sigizmund993/ETZ2067/Screenshot_20261101-164036.png

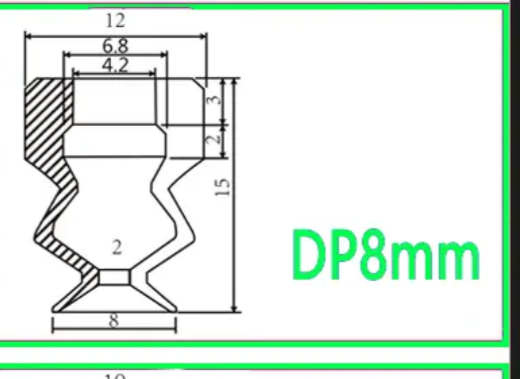
Screenshot_20261101-164036.png
