sigizmund993/ETZ2067/elektronika/etz_plata_3d.png

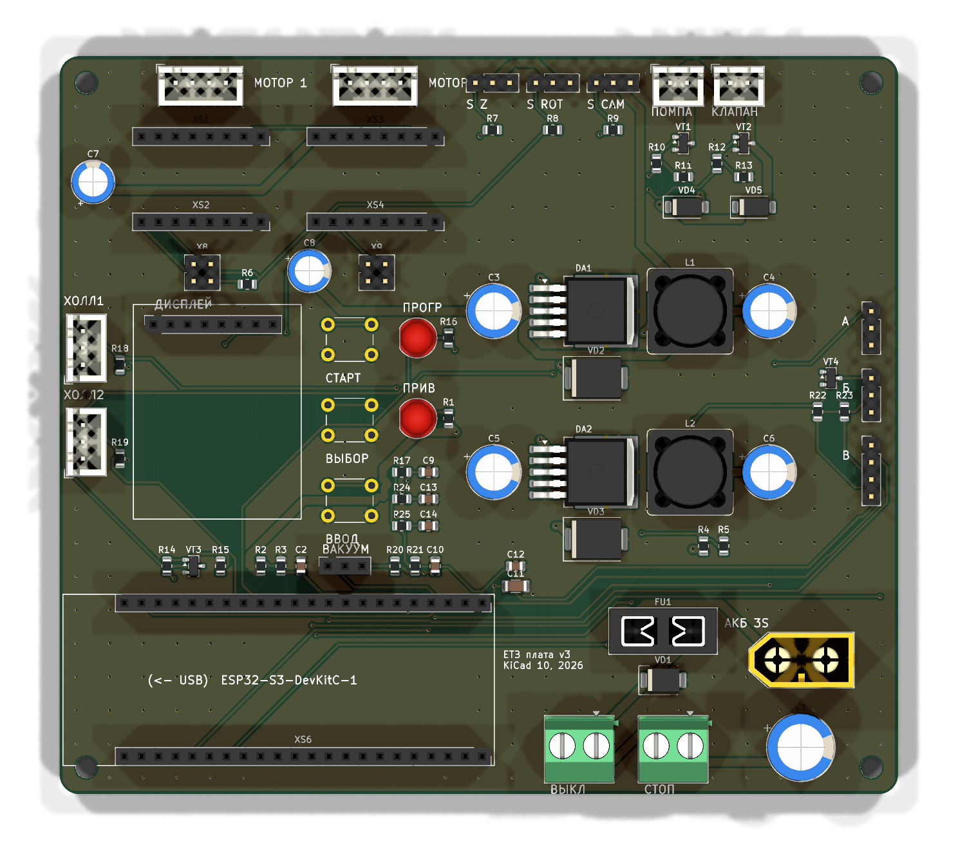
elektronika/etz_plata_3d.png
