sigizmund993/ETZ2067/cam_work_iso.png

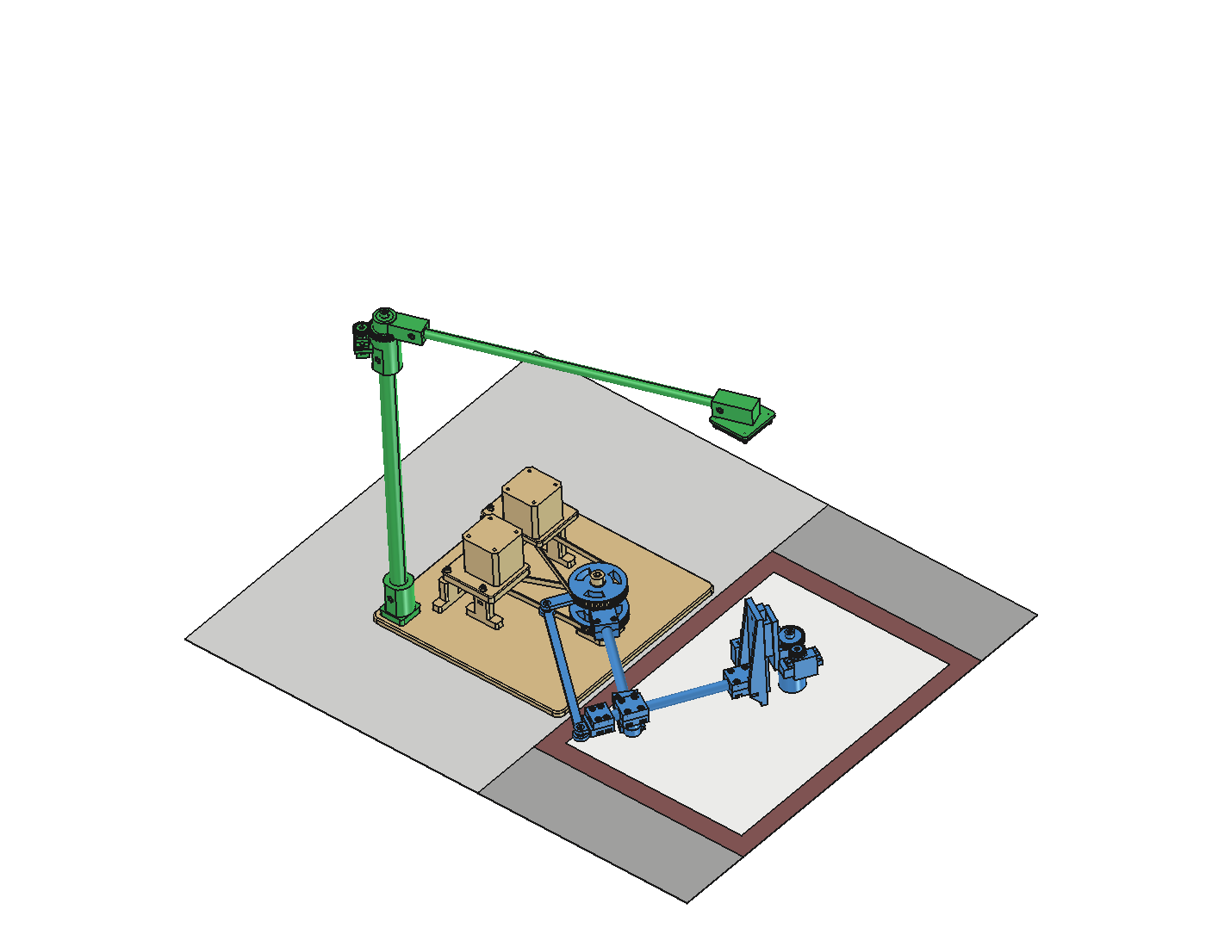
cam_work_iso.png
