sigizmund993/ETZ2067/cam_work_top.png

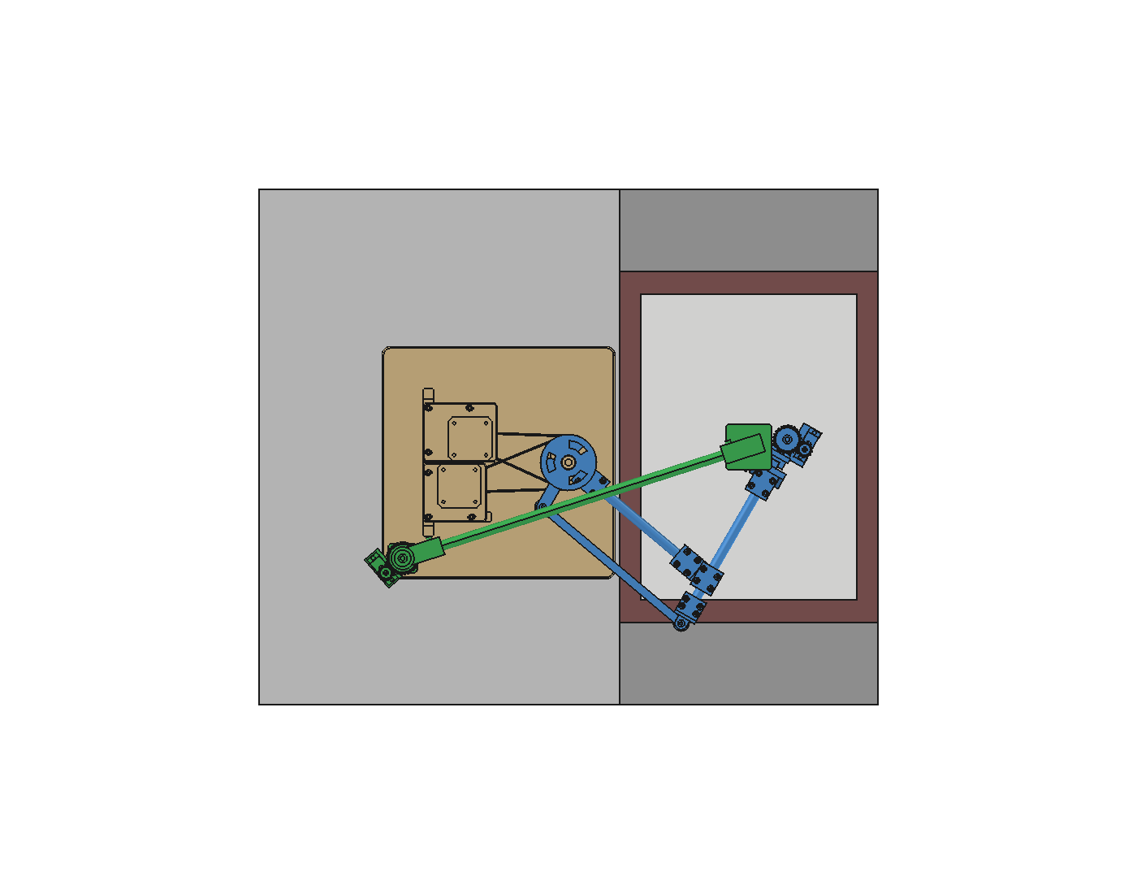
cam_work_top.png
