sigizmund993/ETZ2067/razrez_shtucer_vs_chertezh.png

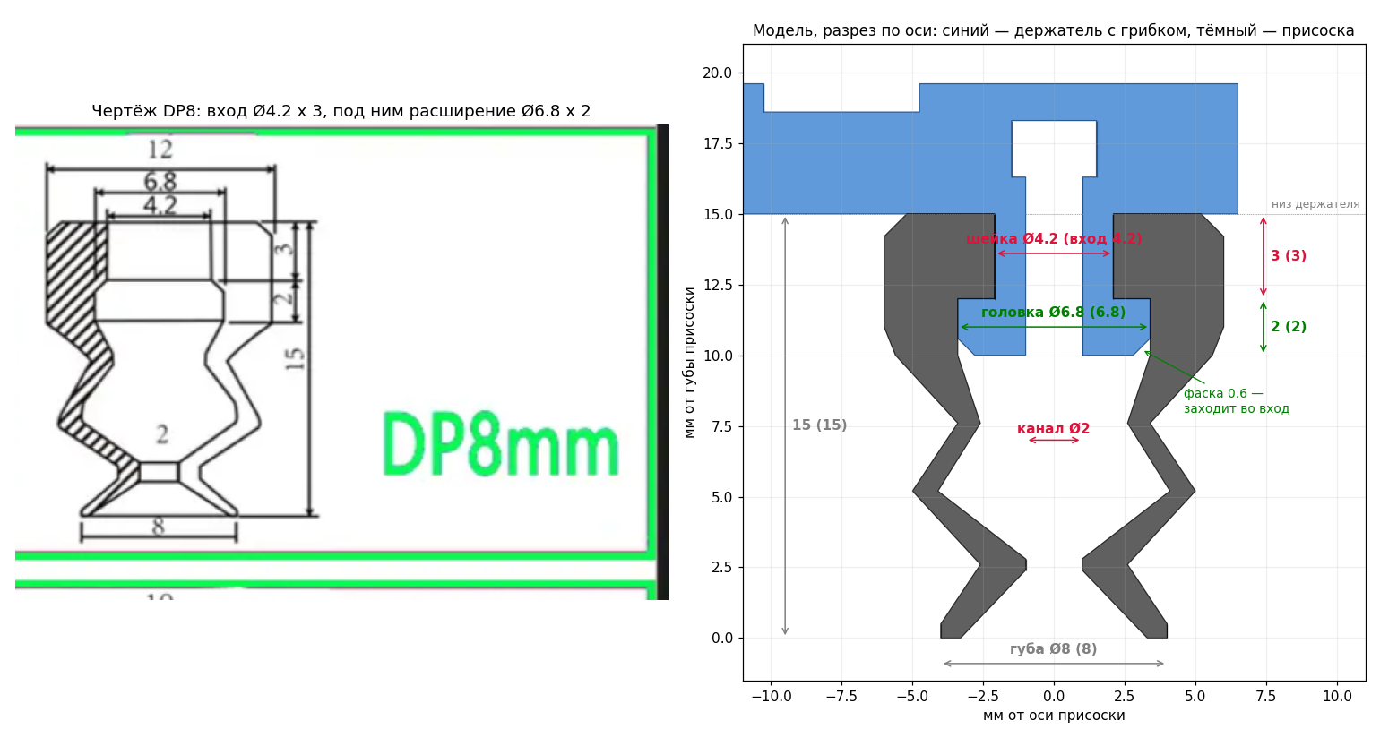
razrez_shtucer_vs_chertezh.png
