sigizmund993/ETZ2067/render_kamera_1_rabota.png

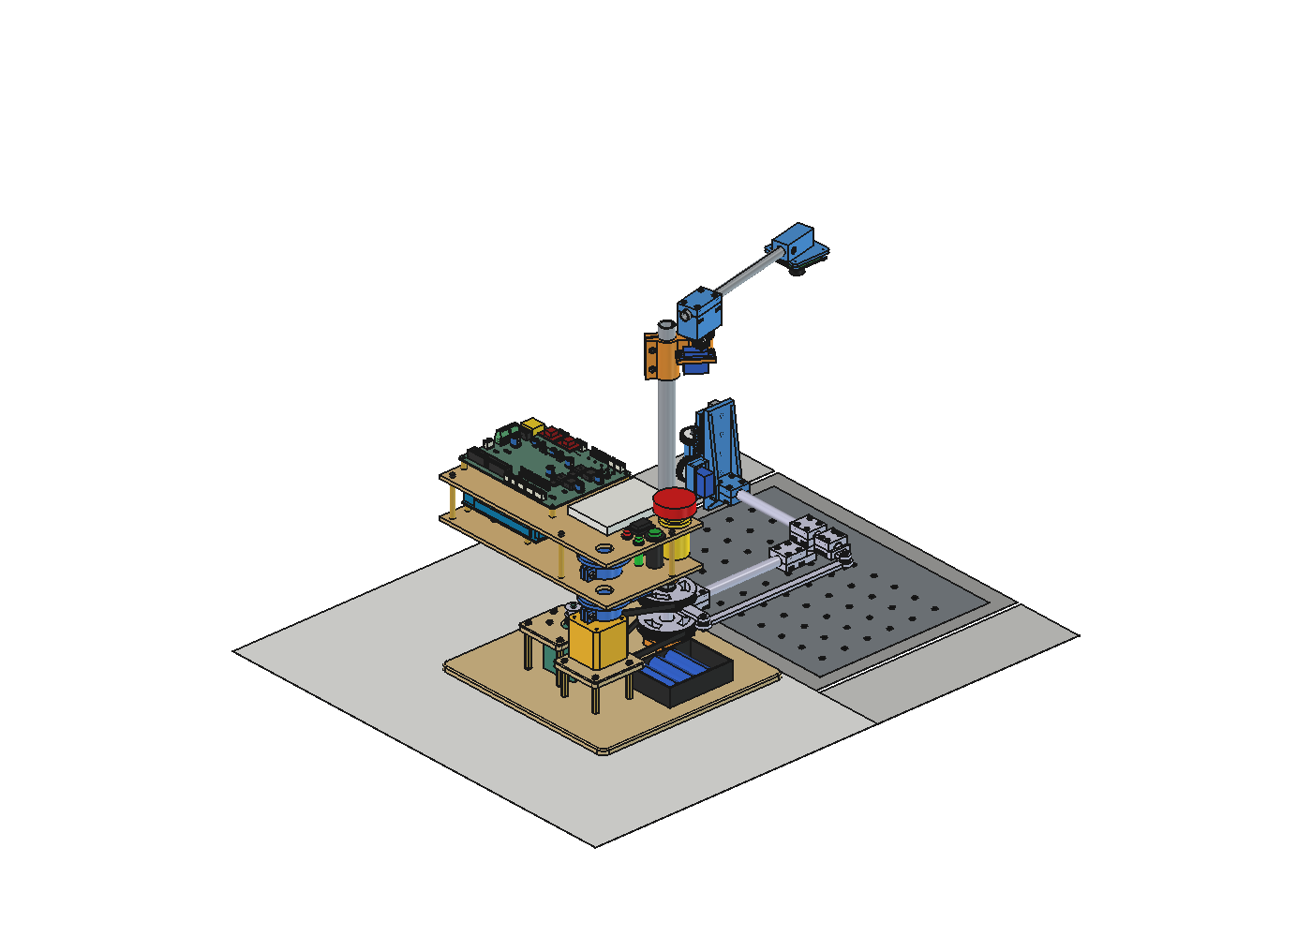
render_kamera_1_rabota.png
