sigizmund993/ETZ2067/render_stoyki_1_obshiy.png

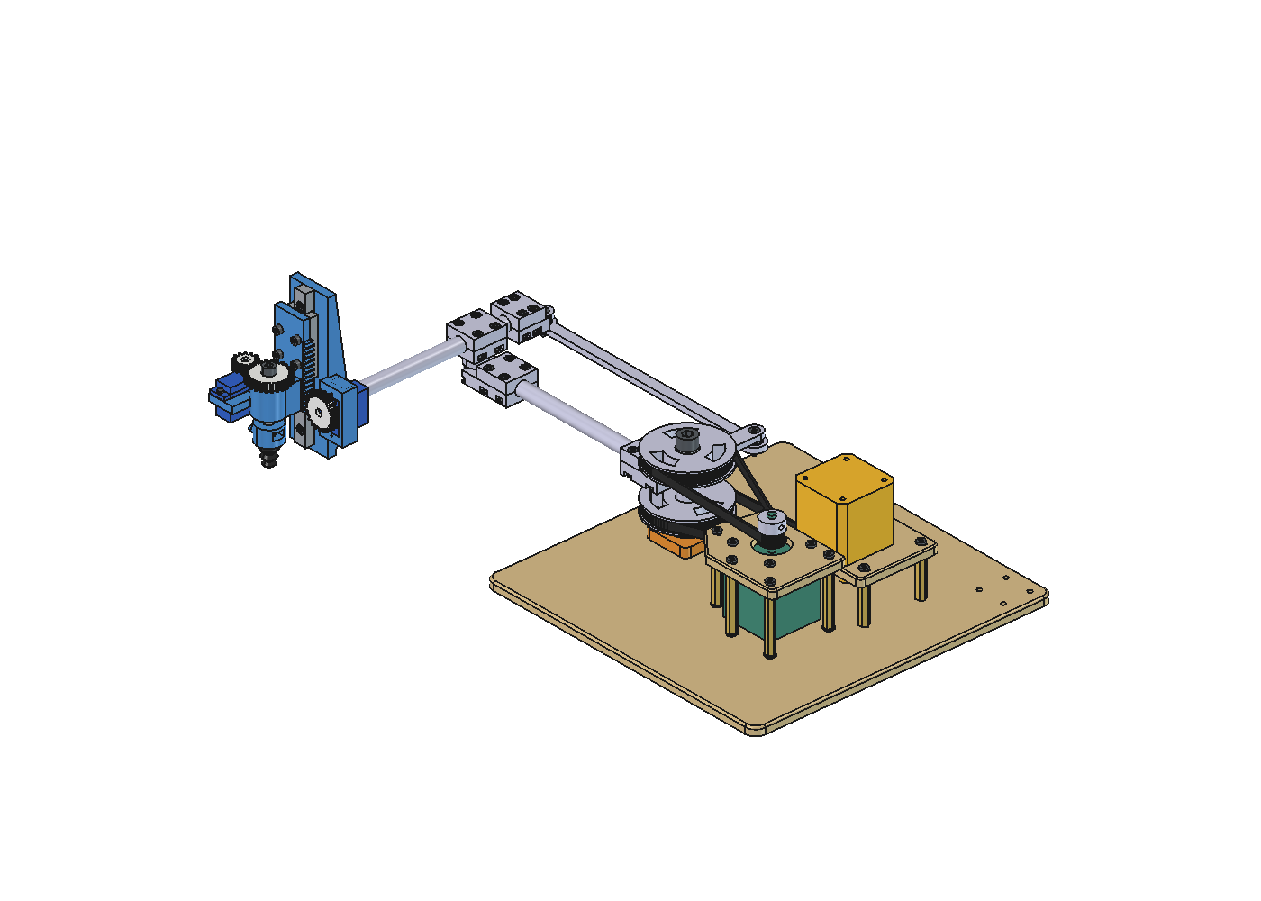
render_stoyki_1_obshiy.png
