sigizmund993/ETZ2067/render_stoyki_2_szadi.png

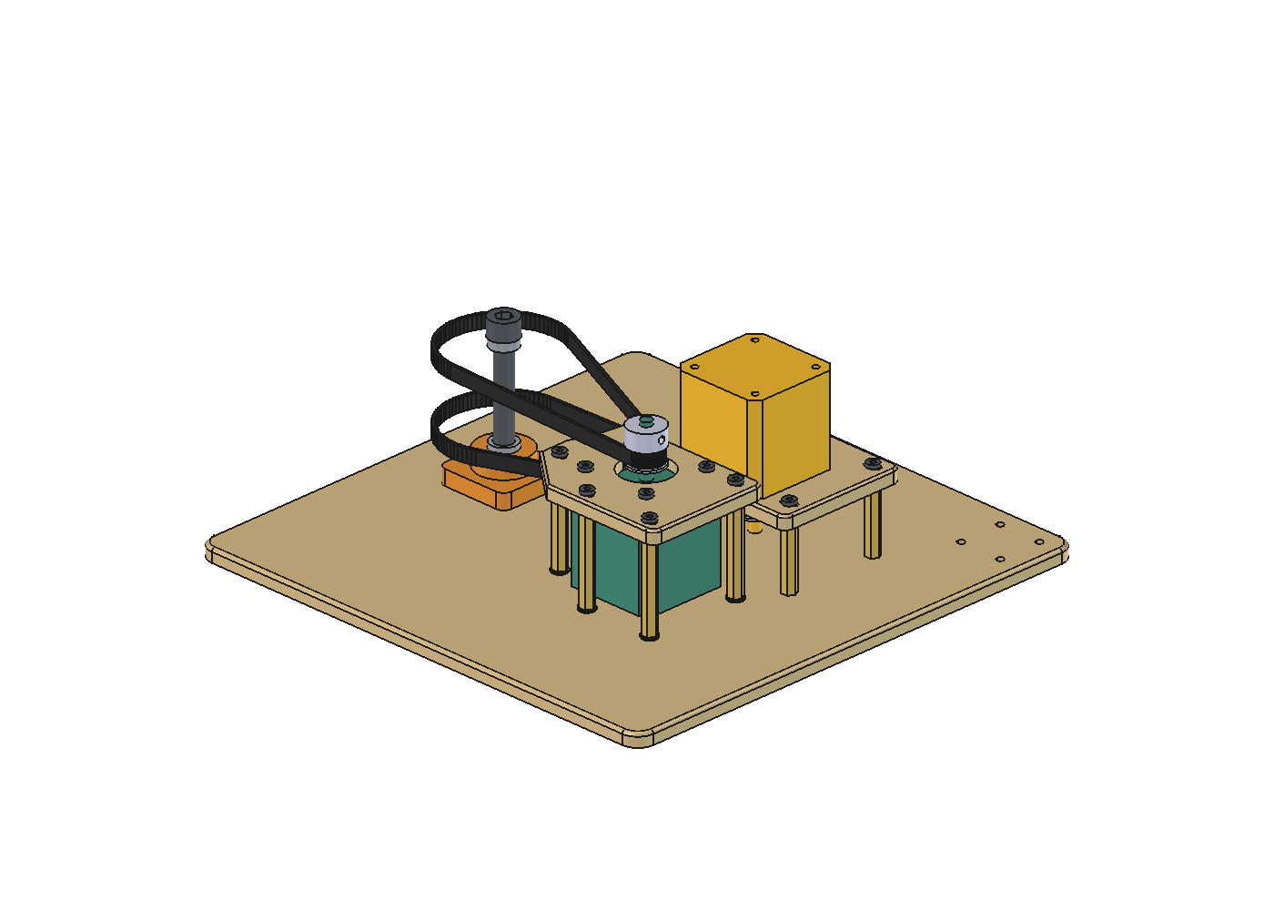
render_stoyki_2_szadi.png
