sigizmund993/ETZ2067/render_stoyki_3_sprava.png

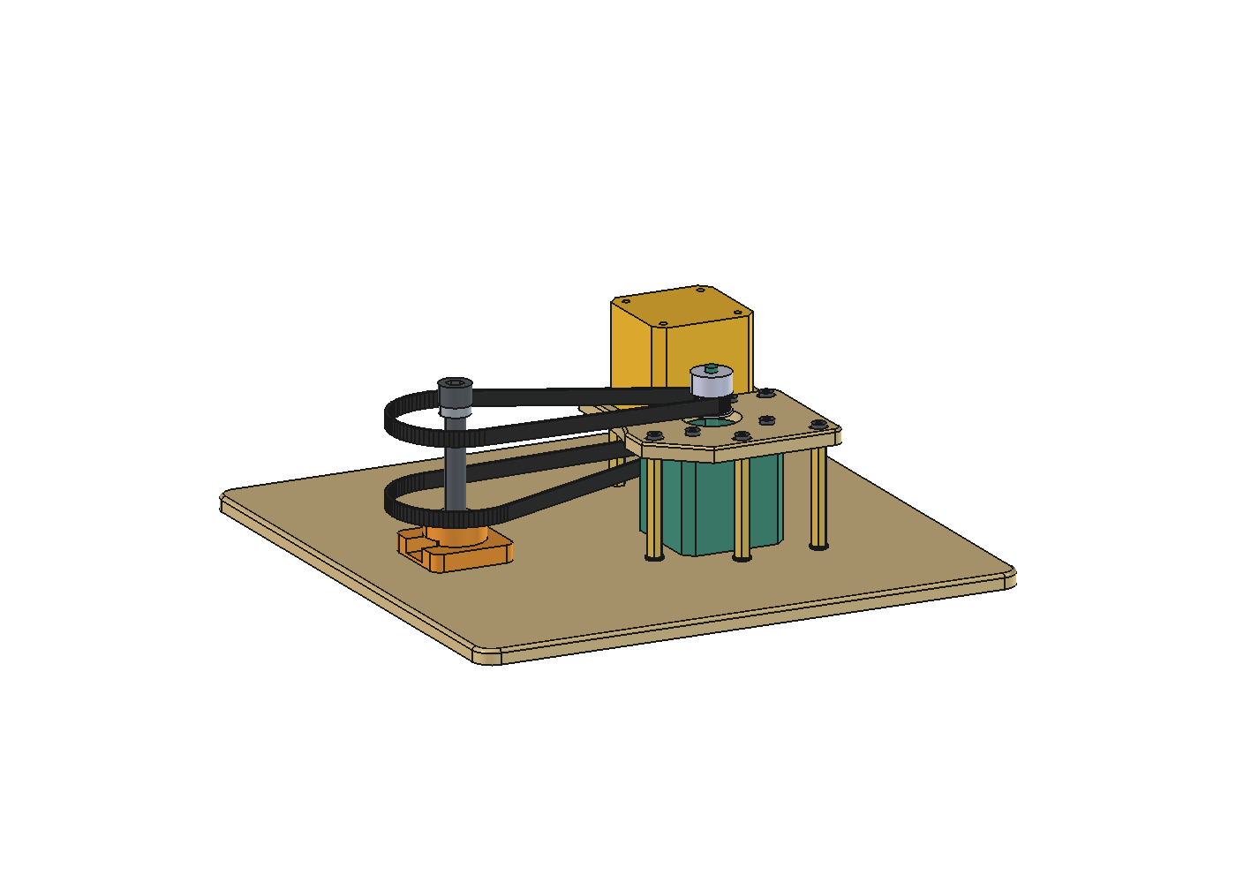
render_stoyki_3_sprava.png
