sigizmund993/ETZ2067/render_zahvat_1_obshiy.png

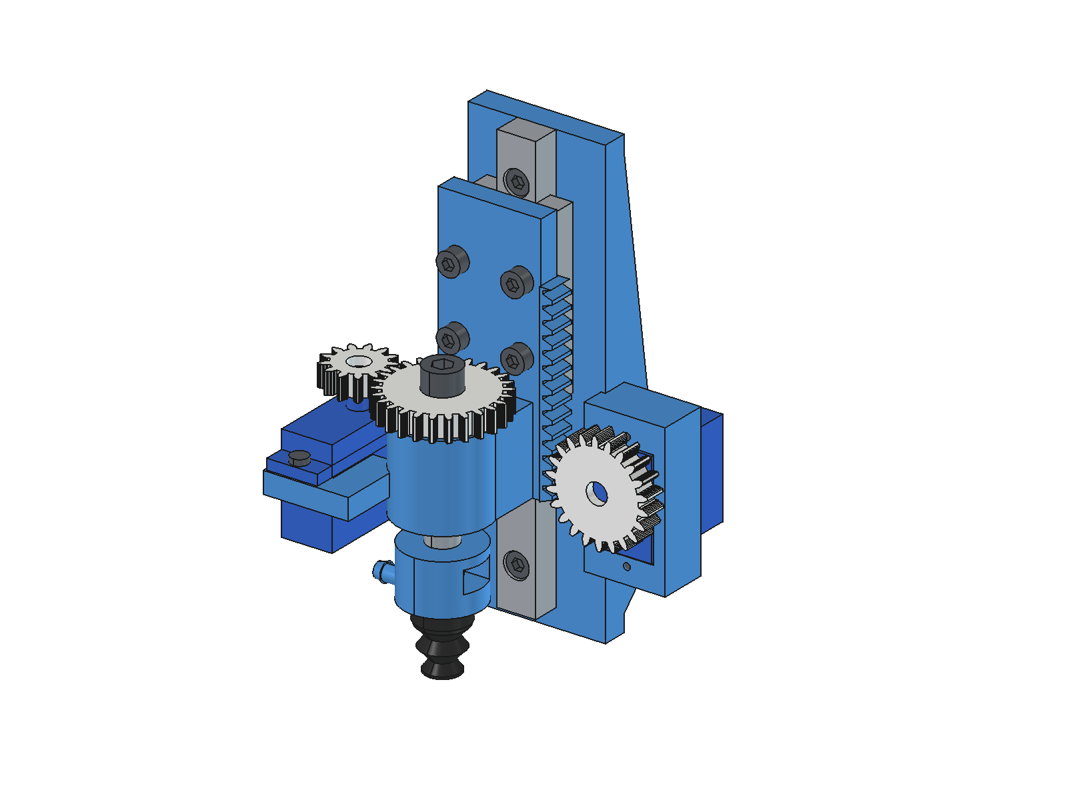
render_zahvat_1_obshiy.png
