sigizmund993/ETZ2067/render_zahvat_2_snizu.png

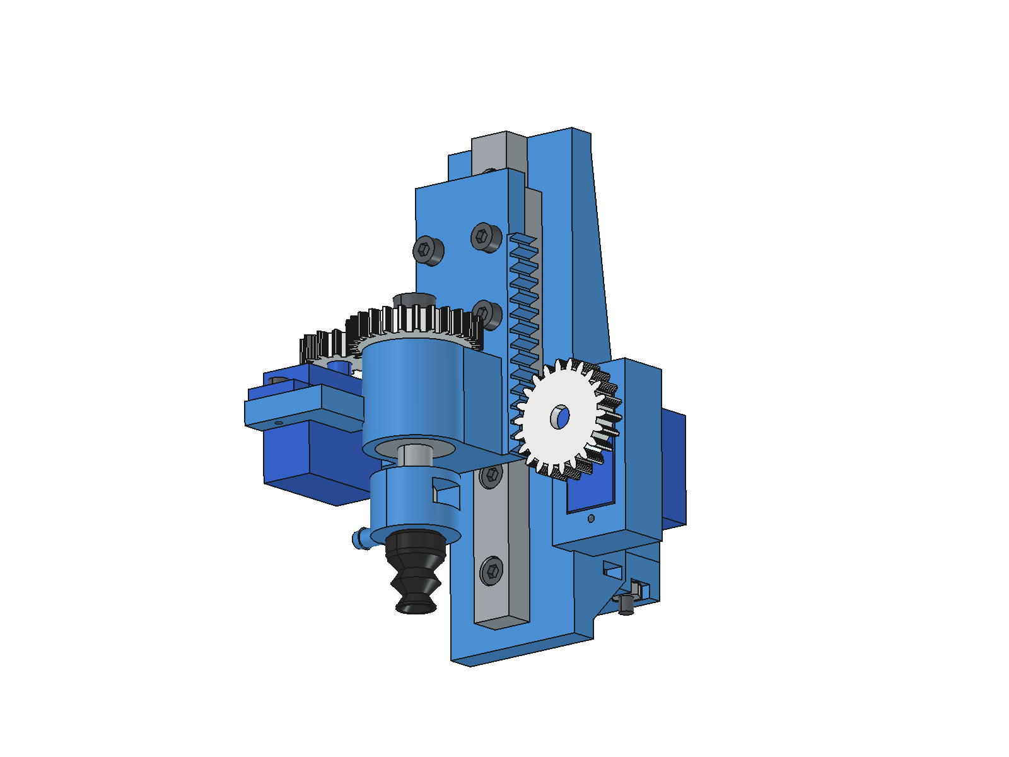
render_zahvat_2_snizu.png
