sigizmund993/ETZ2067/render_zahvat_3_razrez.png

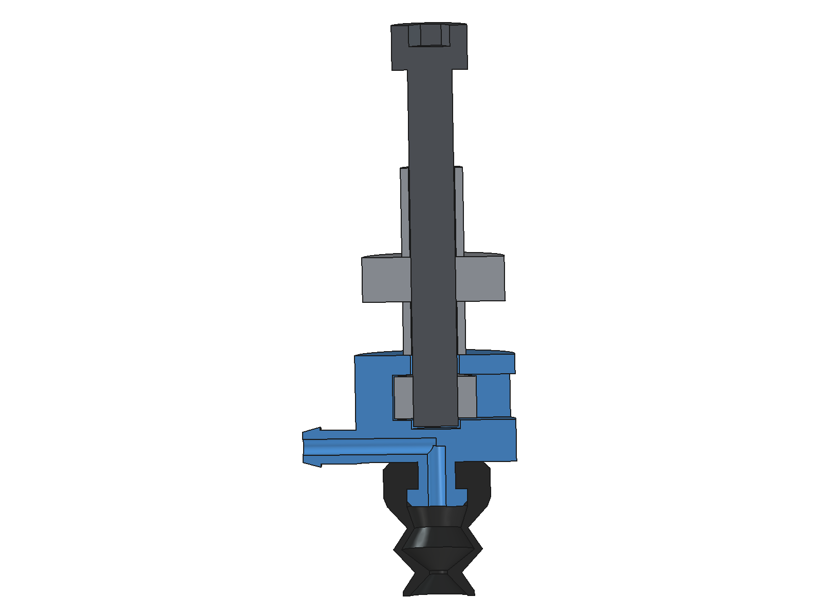
render_zahvat_3_razrez.png
