sigizmund993/ETZ2067/drawbot_import/obj_6_加强杆.STL.stl

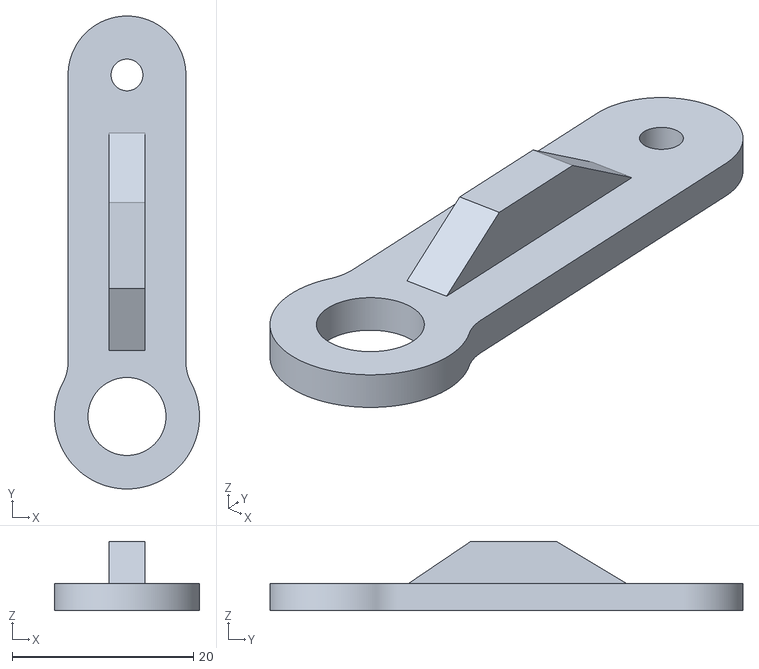
[picture p13: CAD file, 2026-10-07]
drawbot_import/obj_6_加强杆.STL.stl
16.0 x 52.2 x 7.62
