sigizmund993/ETZ2067/elektronika/etz_plata.step

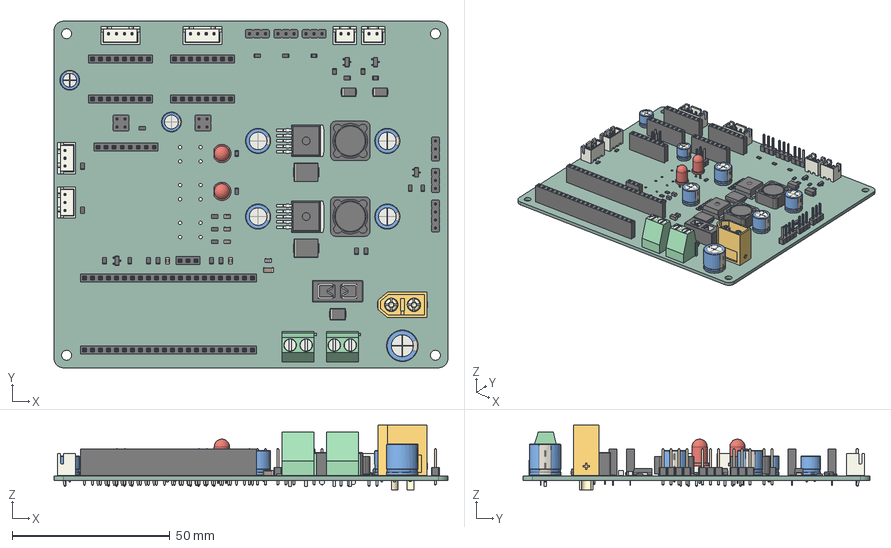
[picture p14: CAD file, 2026-11-04]
elektronika/etz_plata.step
125.0 x 110.0 x 20.5 mm
SRR1260 x 2
JST_B4B_XH_A x 2
R_0805_2012Metric x 25
PinSocket_1x08_P2.54mm_Vertical x 5
CP_Radial_D100mm_P500mm
PinHeader_1x03_P254mm_Vertical x 5
TerminalBlock_Phoenix_MKDS-1,5-2-5.08_1x02_P5.08mm_Horizontal x 2
a648ce37-9c39-11ed-93f0-dde97e994e83_part x 2
a648ce38-9c39-11ed-93f0-dde97e994e83_part x 2
a648ce39-9c39-11ed-93f0-dde97e994e83_part x 2
D_SMC x 2
LED_D5.0mm x 2
JST_B2B_XH_A x 2
D_SMA x 2
CP_Radial_D80mm_P350mm x 4
SOT-23 x 4
C_0805_2012Metric x 6
D_SMB
JST_B3B_XH_A x 2
PinHeader_1x04_P254mm_Vertical
CP_Radial_D63mm_P250mm x 2
PinSocket_1x03_P2.54mm_Vertical
PinHeader_2x02_P254mm_Vertical x 2
PinSocket_1x22_P2.54mm_Vertical x 2
C_1206_3216Metric
A_Keystone_3568
XT60 male v9
etz_plata_PCB
