sigizmund993/ETZ2067/ETZ_Robot.FCStd

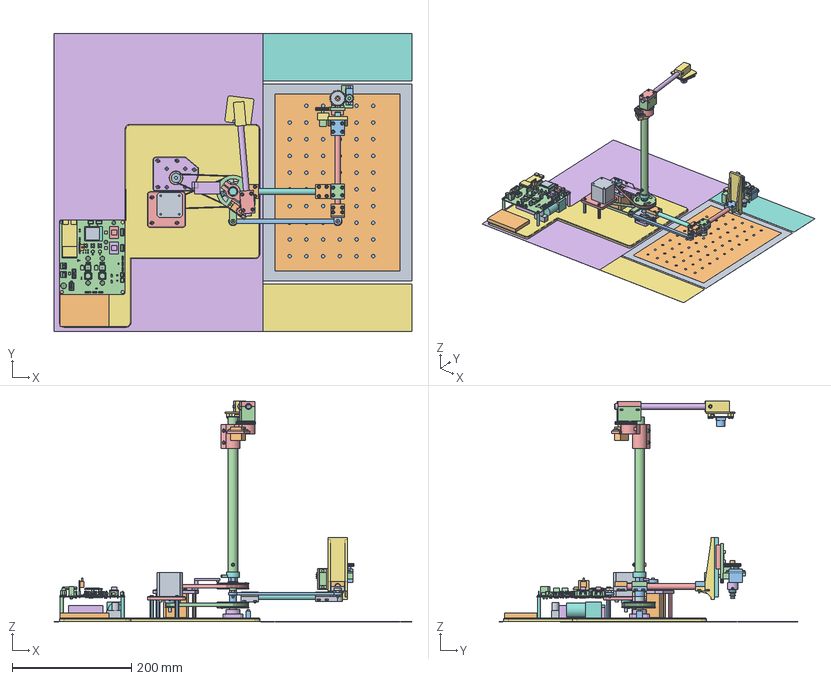
[picture p15: CAD file, 2026-11-04]
ETZ_Robot.FCStd
600.0 x 500.0 x 370.0 mm
Шкив_ведомый
Крышка_хомута
Проставка_шкивов
Шкив_ведомый_2
Винт_M3x16_1
Гайка_M3_1
Винт_M3x16_2
Гайка_M3_2
Винт_M3x16_3
Гайка_M3_3
Винт_M3x16_4
Гайка_M3_4
Подшипник_608ZZ_1
Подшипник_608ZZ_2
Магнит_3x1_шкив_1
Магнит_3x1_шкив_2
Мотор_NEMA17_левый
Мотор_NEMA17_правый
Шкив_ведущий_20T x 2
Каретка_Z_плита_шпиндель
Каретка_MGN9H
Винт_каретки_M3x8_1
Винт_каретки_M3x8_2
Винт_каретки_M3x8_3
Винт_каретки_M3x8_4
Подшипник_шпинделя_625ZZ_1
Подшипник_шпинделя_625ZZ_2
Втулка_шпинделя_Ø7/Ø5.2x10
Удлинитель_шпинделя_Ø7/Ø5.2x6
Держатель_присоски_печать
Гайка_держателя_M5
Присоска_DP8
Шестерня_шпинделя_m1_z26
Винт_шпинделя_M5x40_ISO4762
Серво_поворота_SG90
Шестерня_поворота_m1_z13
Саморез_SG90_2x6_пов_1
Саморез_SG90_2x6_пов_2
Кронштейн_Z
Рельс_MGN9_100мм
Вставка_резьбовая_M3x5_1
Винт_рельса_M3x8_1
Вставка_резьбовая_M3x5_2
Винт_рельса_M3x8_2
Вставка_резьбовая_M3x5_3
Винт_рельса_M3x8_3
Вставка_резьбовая_M3x5_4
Винт_рельса_M3x8_4
Вставка_резьбовая_M3x5_5
Винт_рельса_M3x8_5
Кронштейн_Z_крышка
Винт_кронштейна_M3x16_1
Гайка_кронштейна_M3_1
Винт_кронштейна_M3x16_2
Гайка_кронштейна_M3_2
Винт_кронштейна_M3x16_3
Гайка_кронштейна_M3_3
Винт_кронштейна_M3x16_4
Гайка_кронштейна_M3_4
Серво_Z_SG90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
