sigizmund993/ETZ2067/print/derzhatel_prisoski_K1C_PETG.3mf

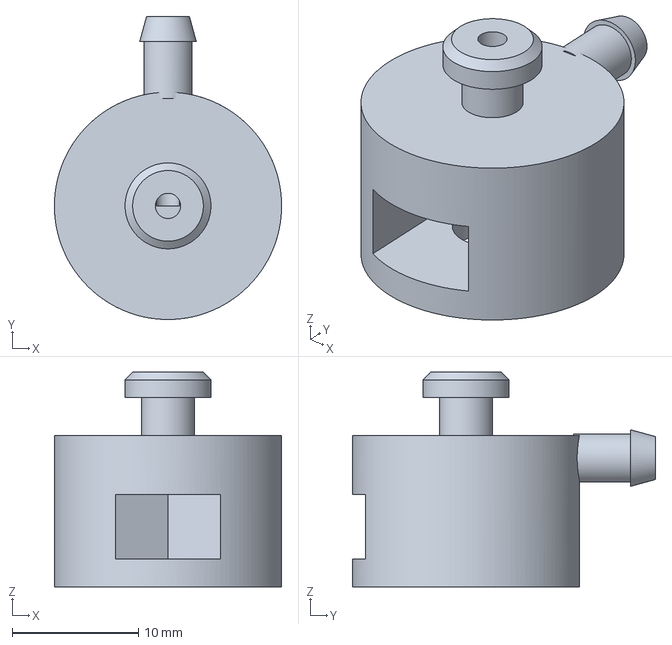
[picture p16: CAD file, 2026-11-02]
print/derzhatel_prisoski_K1C_PETG.3mf
18.0 x 24.0 x 17.0 mm
