sigizmund993/ETZ2067/print/orca/enforcer_karetka_Z_P1S.stl

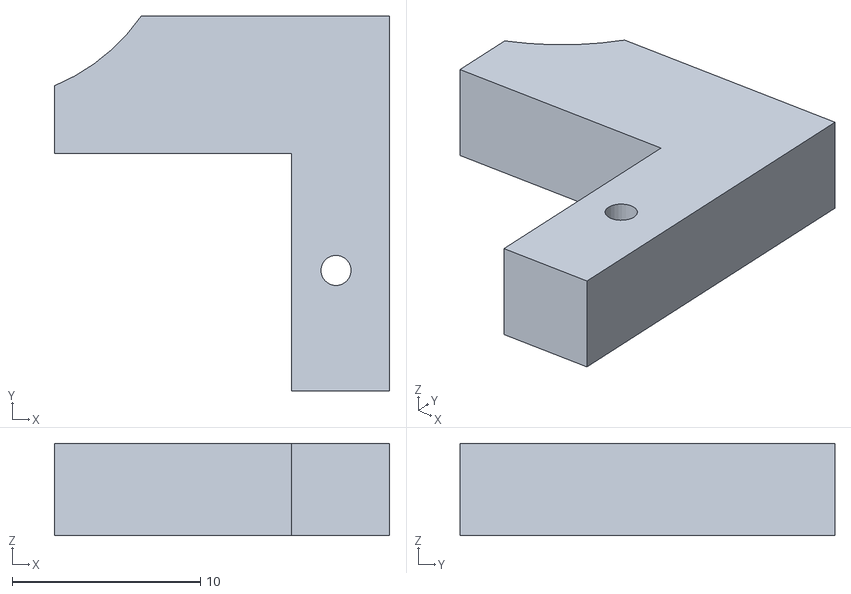
[picture p17: CAD file, 2026-11-02]
print/orca/enforcer_karetka_Z_P1S.stl
17.8 x 19.9 x 4.90
