sigizmund993/ETZ2067/drawbot_import/obj_15_笔夹连接座上.STL.stl

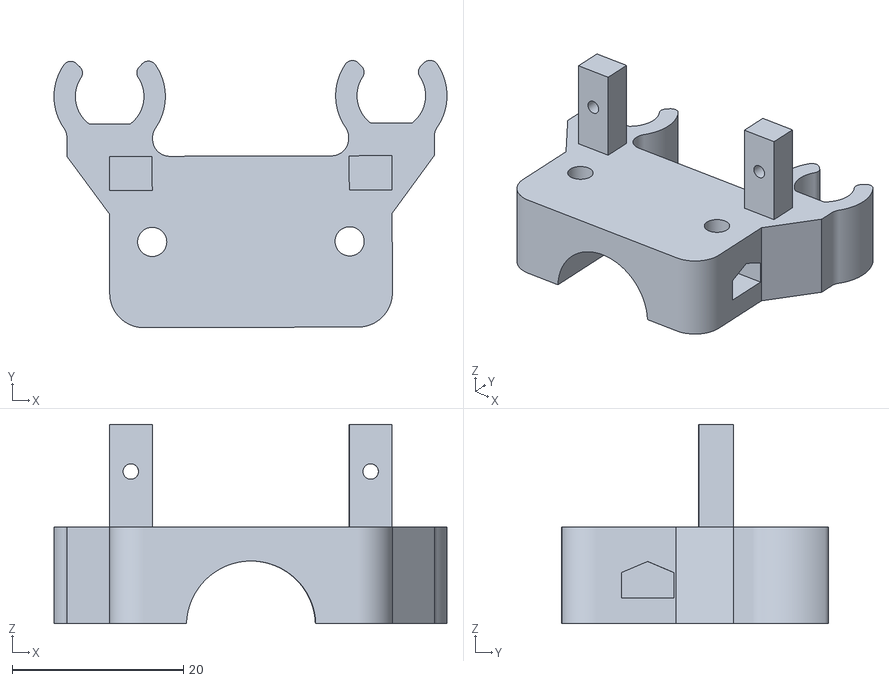
[picture p18: CAD file, 2026-10-07]
drawbot_import/obj_15_笔夹连接座上.STL.stl
45.9 x 31.2 x 23.2
