sigizmund993/ETZ2067/ETZ_Poligon.FCStd

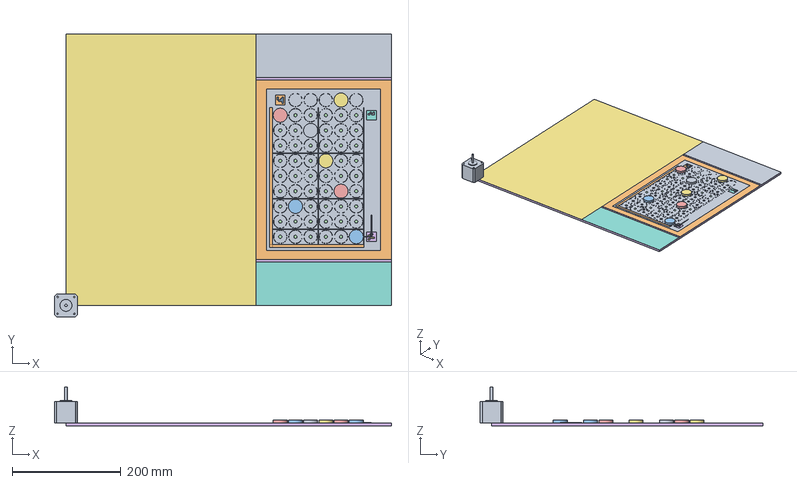
[picture p19: CAD file, 2026-10-07]
ETZ_Poligon.FCStd
621.1 x 521.1 x 71.0 mm
Лист А4
Черные полосы
Красная сетка
Круги Ø6 (центры клеток)
Окружности Ø24,5 и столбец отбоя
ArUco id 27
ArUco id 27 (белое)
ArUco id 28
ArUco id 28 (белое)
ArUco id 29
ArUco id 29 (белое)
Ось OX поля
Ось OY поля
Основание 600x500
Зона 1 (350x500)
Зона 2 нижняя (250x80)
Зона 2 верхняя (250x80)
Область операционного поля (250x330)
Шашка А0 red
Шайба М8 А0
Шашка Б3 green
Шайба М8 Б3
Шашка В5 blue
Шайба М8 В5
Шашка Г7 yellow
Шайба М8 Г7
Шашка Д2 magenta
Шайба М8 Д2
Шашка Е8 red
Шайба М8 Е8
Шашка Отбой2 blue
Шайба М8 Отбой2
