sigizmund993/ETZ2067/print/karetka_Z_P1S_PLA.3mf

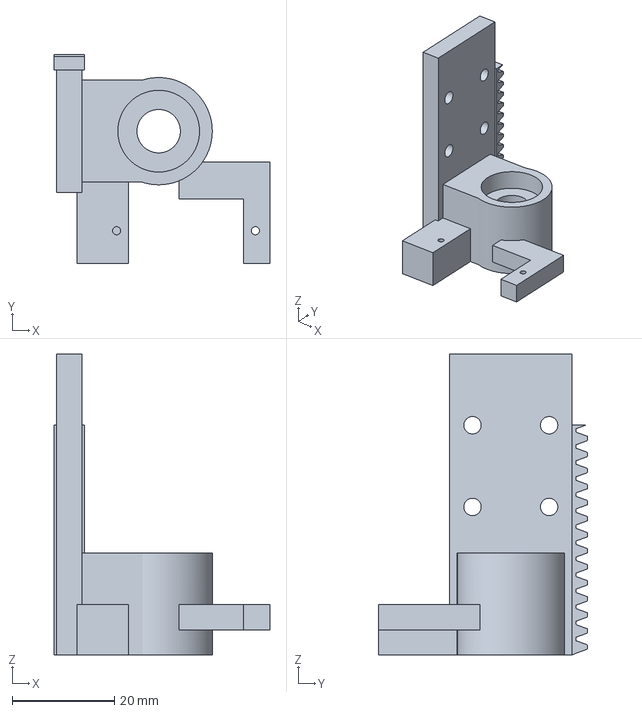
[picture p20: CAD file, 2026-11-02]
print/karetka_Z_P1S_PLA.3mf
42.3 x 40.9 x 59.0 mm
