sigizmund993/ETZ2067/drawbot_import/obj_16_笔夹连接座下.STL.stl

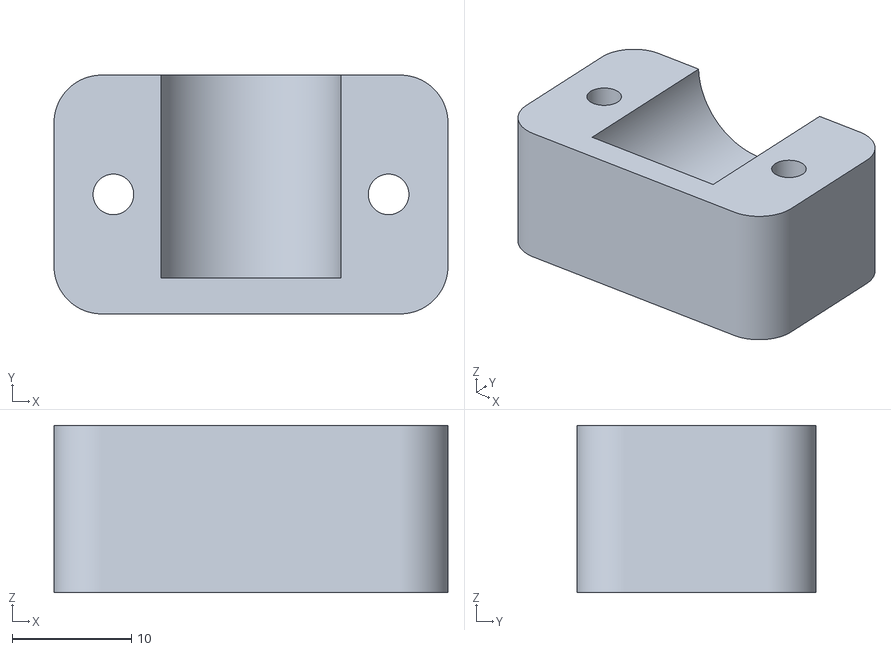
[picture p21: CAD file, 2026-10-07]
drawbot_import/obj_16_笔夹连接座下.STL.stl
33.0 x 20.0 x 14.0
