sigizmund993/ETZ2067/print/orca/derzhatel_3_K1C_enf.3mf

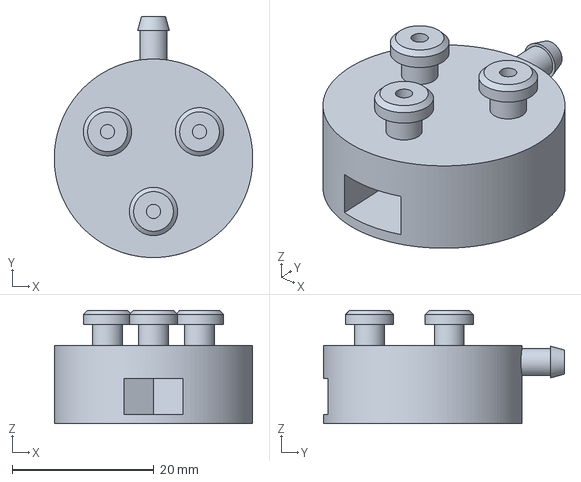
[picture p22: CAD file, 2026-11-02]
print/orca/derzhatel_3_K1C_enf.3mf
28.0 x 34.0 x 16.0 mm
