sigizmund993/ETZ2067/drawbot_import/obj_10_底座.STL.stl

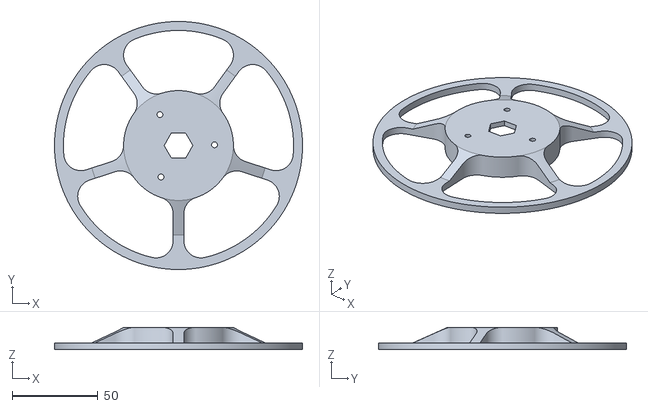
[picture p23: CAD file, 2026-10-07]
drawbot_import/obj_10_底座.STL.stl
144.5 x 144.5 x 13.0
