sigizmund993/ETZ2067/drawbot_import/obj_14_笔夹滑块.STL.stl

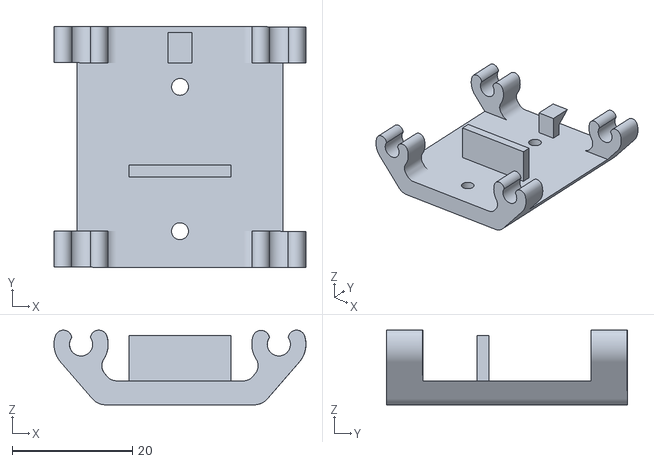
[picture p25: CAD file, 2026-10-07]
drawbot_import/obj_14_笔夹滑块.STL.stl
41.9 x 40.0 x 12.4
