sigizmund993/ETZ2067/print/orca/enforcer_derzhatel_3_K1C.stl

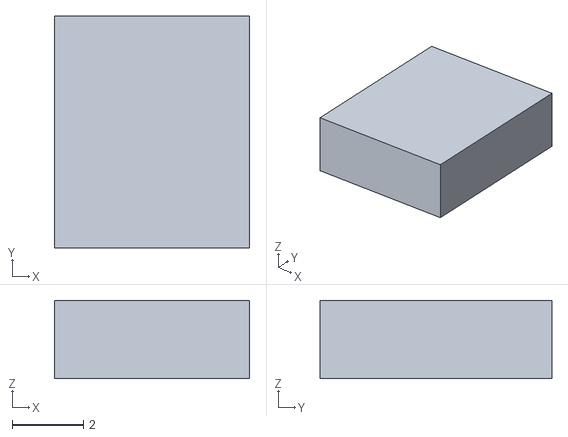
[picture p26: CAD file, 2026-11-02]
print/orca/enforcer_derzhatel_3_K1C.stl
5.50 x 6.53 x 2.20
