sigizmund993/ETZ2067/print/shesterni_uzla_P1S_PLA.gcode.3mf

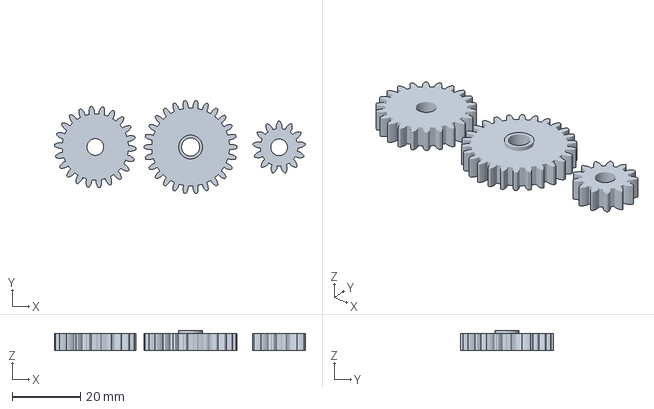
[picture p27: CAD file, 2026-11-02]
print/shesterni_uzla_P1S_PLA.gcode.3mf
73.8 x 27.3 x 6.00 mm
