sigizmund993/ETZ2067/drawbot_import/obj_8_大臂驱动轮.STL.stl

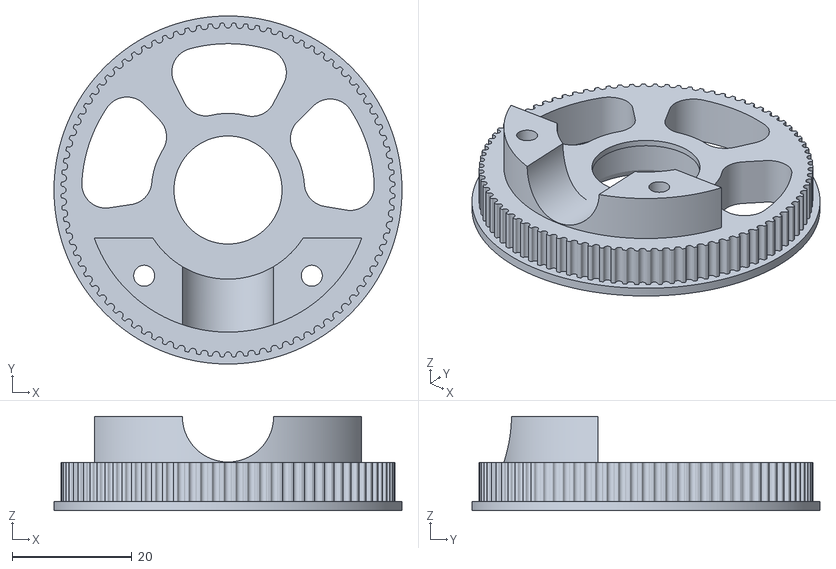
[picture p28: CAD file, 2026-10-07]
drawbot_import/obj_8_大臂驱动轮.STL.stl
58.0 x 58.0 x 15.7
