sigizmund993/ETZ2067/drawbot_import/obj_13_电机固定支架.STL.stl

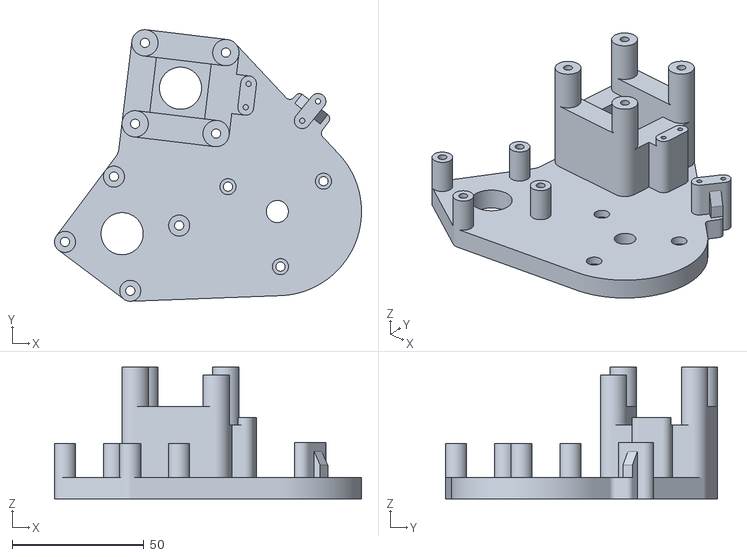
[picture p29: CAD file, 2026-10-07]
drawbot_import/obj_13_电机固定支架.STL.stl
116.7 x 103.3 x 50.0
