sigizmund993/ETZ2067/drawbot_import/obj_18_驱动轮垫圈.STL.stl

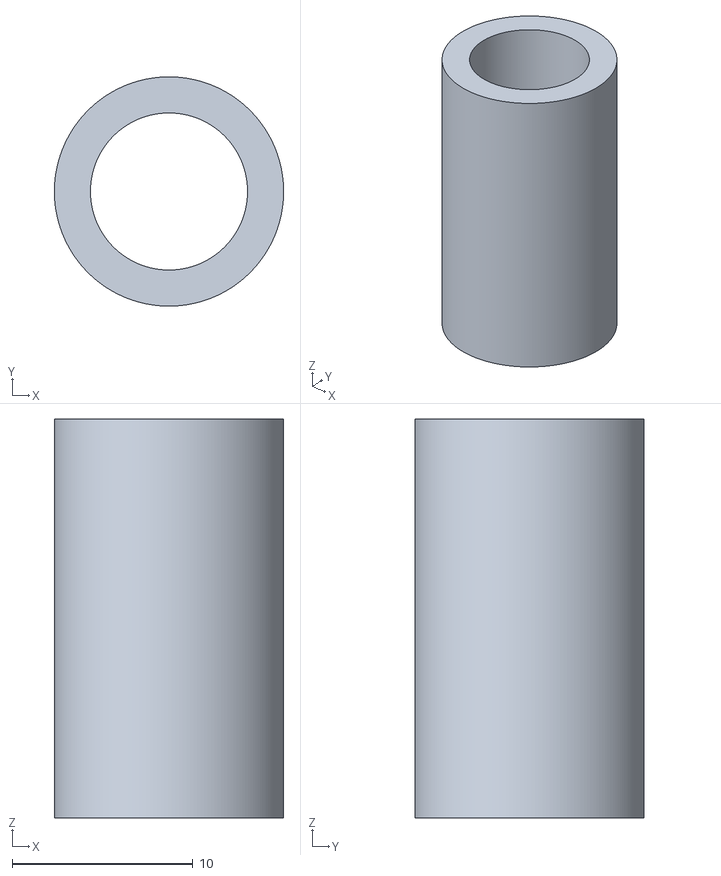
[picture p30: CAD file, 2026-10-07]
drawbot_import/obj_18_驱动轮垫圈.STL.stl
12.7 x 12.7 x 22.1
