sigizmund993/ETZ2067/drawbot_import/obj_12_拐角下.STL.stl

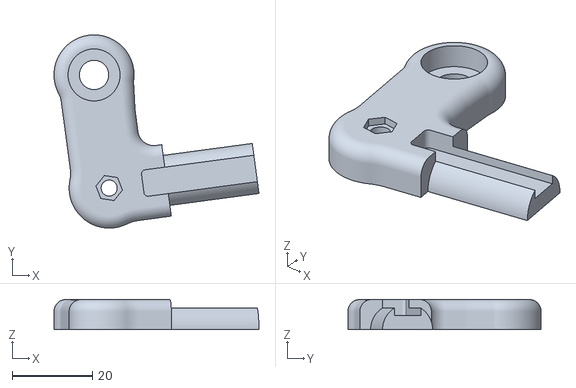
[picture p31: CAD file, 2026-10-07]
drawbot_import/obj_12_拐角下.STL.stl
51.2 x 48.2 x 7.50
