sigizmund993/ETZ2067/print/orca/enforcer_kronshtein_Z.stl

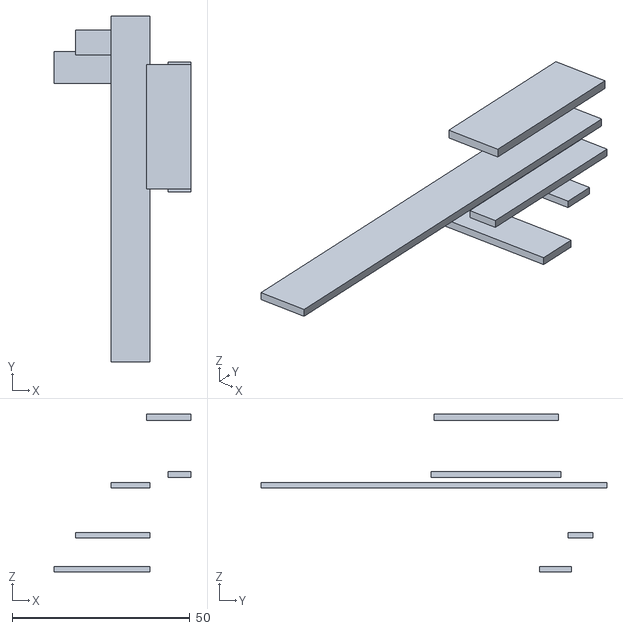
[picture p32: CAD file, 2026-11-01]
print/orca/enforcer_kronshtein_Z.stl
38.5 x 97.3 x 44.4
