sigizmund993/ETZ2067/drawbot_import/obj_1_15mm_bracket_1.STL.stl

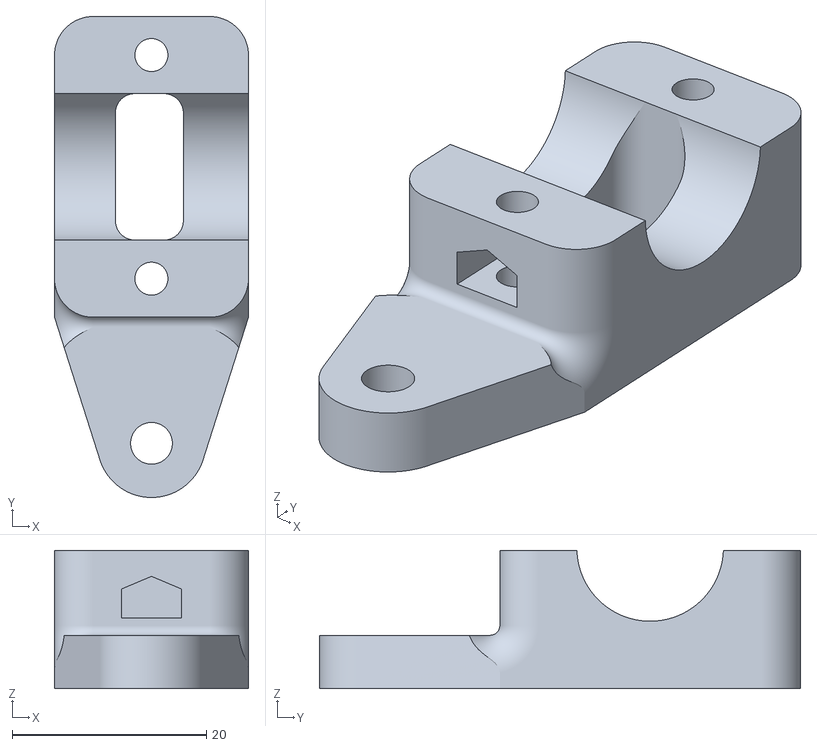
[picture p33: CAD file, 2026-10-07]
drawbot_import/obj_1_15mm_bracket_1.STL.stl
20.0 x 49.6 x 14.2
