sigizmund993/ETZ2067/print/orca/kronshtein_Z_enf.3mf

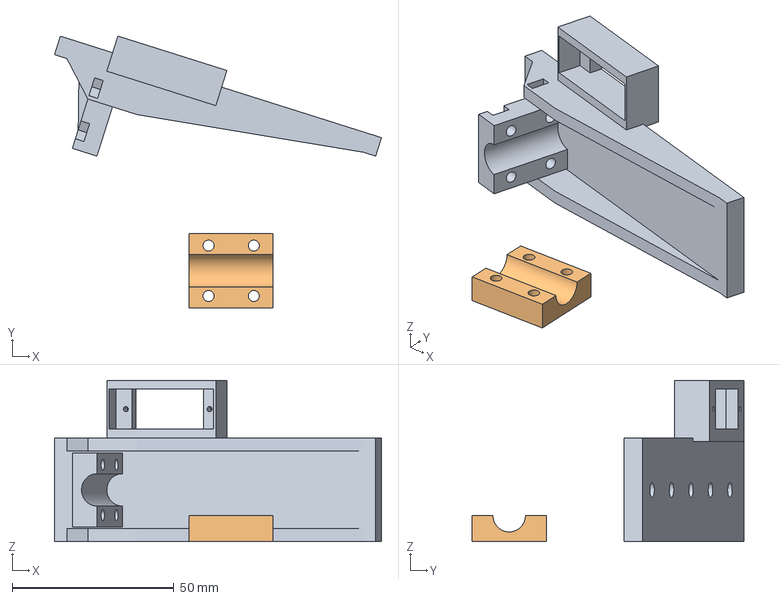
[picture p34: CAD file, 2026-11-01]
print/orca/kronshtein_Z_enf.3mf
101.2 x 84.2 x 49.9 mm
kronshtein_Z.stl
kronshtein_Z_kryshka.stl
