sigizmund993/ETZ2067/drawbot_import/obj_9_大臂驱动轮固定盖.STL.stl

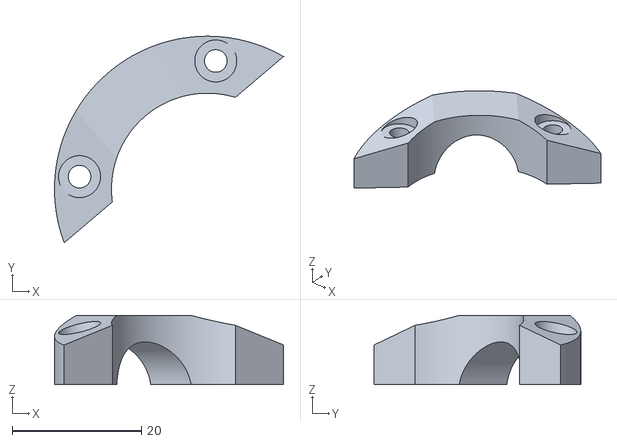
[picture p35: CAD file, 2026-10-07]
drawbot_import/obj_9_大臂驱动轮固定盖.STL.stl
35.5 x 32.0 x 10.7
