sigizmund993/ETZ2067/drawbot_import/obj_11_拐角上.STL.stl

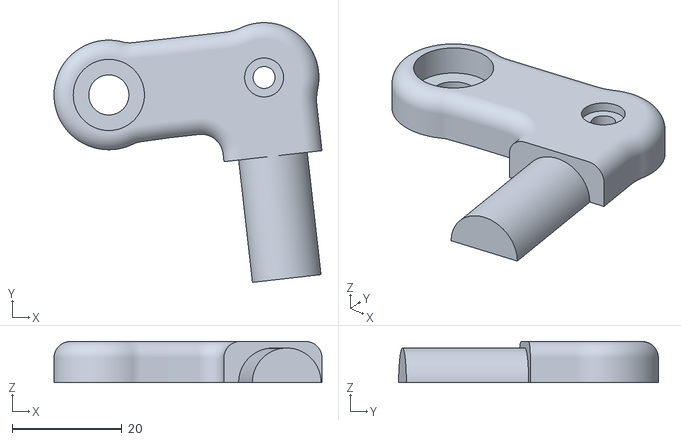
[picture p36: CAD file, 2026-10-07]
drawbot_import/obj_11_拐角上.STL.stl
48.9 x 47.4 x 7.50
