sigizmund993/ETZ2067/drawbot_import/obj_5_副臂驱动轮.STL.stl

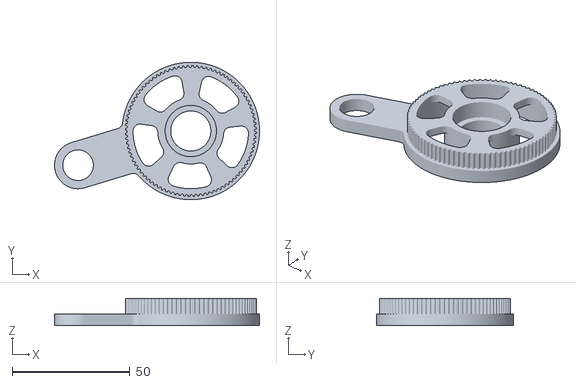
[picture p37: CAD file, 2026-10-07]
drawbot_import/obj_5_副臂驱动轮.STL.stl
87.0 x 58.3 x 11.5
