sigizmund993/ETZ2067/print/kronshtein_Z.stl

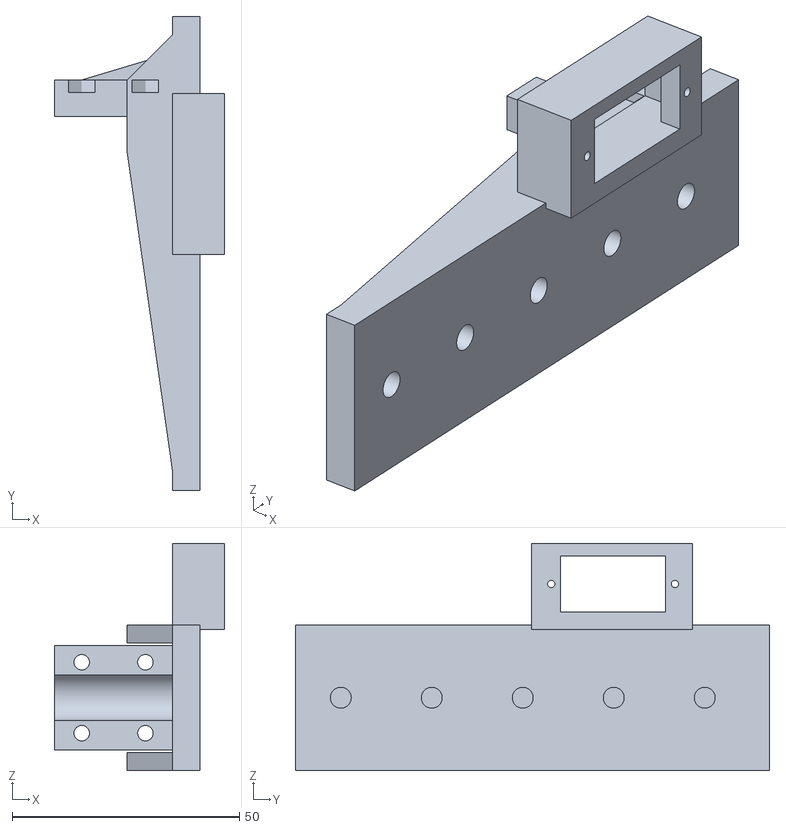
[picture p38: CAD file, 2026-11-01]
print/kronshtein_Z.stl
37.4 x 104.3 x 49.9
