sigizmund993/ETZ2067/drawbot_import/obj_17_笔架.STL.stl

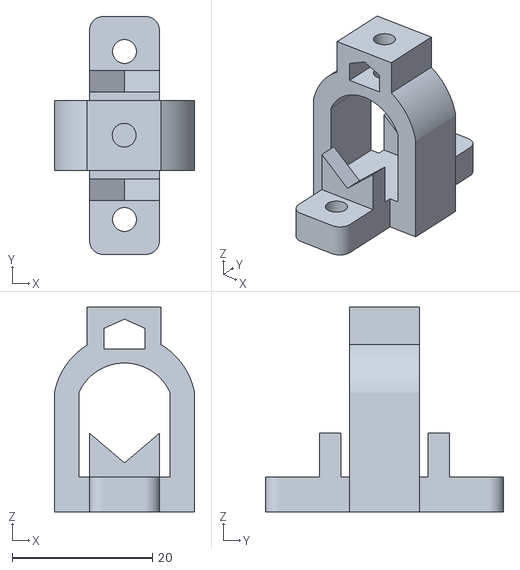
[picture p39: CAD file, 2026-10-07]
drawbot_import/obj_17_笔架.STL.stl
20.0 x 34.0 x 29.3
