sigizmund993/ETZ2067/print/kronshtein_Z_kryshka.stl

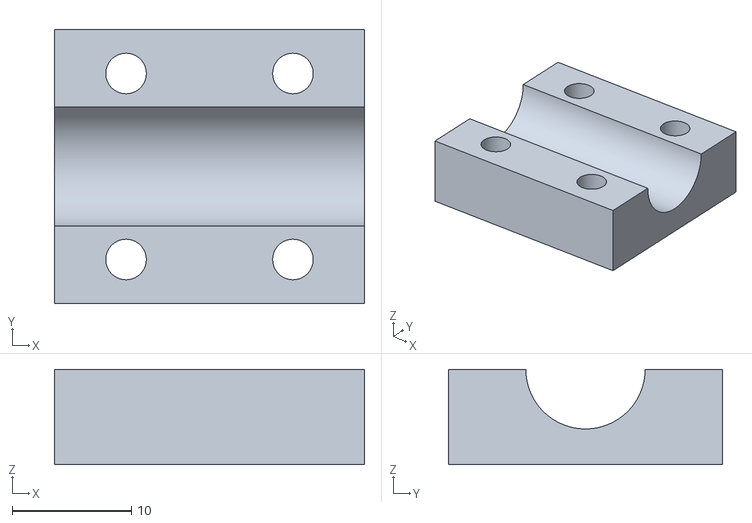
[picture p40: CAD file, 2026-11-01]
print/kronshtein_Z_kryshka.stl
26.0 x 23.0 x 8.00
