sigizmund993/ETZ2067/drawbot_import/obj_3_arm2_end（rev3）.STL.stl

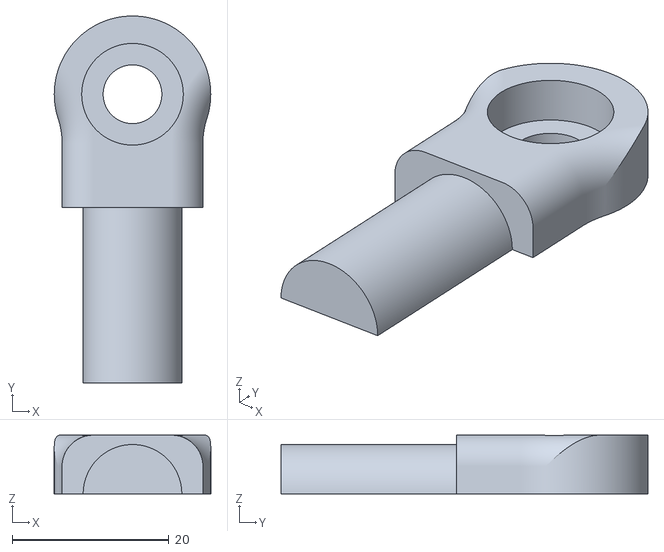
[picture p41: CAD file, 2026-10-07]
drawbot_import/obj_3_arm2_end（rev3）.STL.stl
20.0 x 46.9 x 7.50
