sigizmund993/ETZ2067/drawbot_import/obj_7_大臂接头下.STL.stl

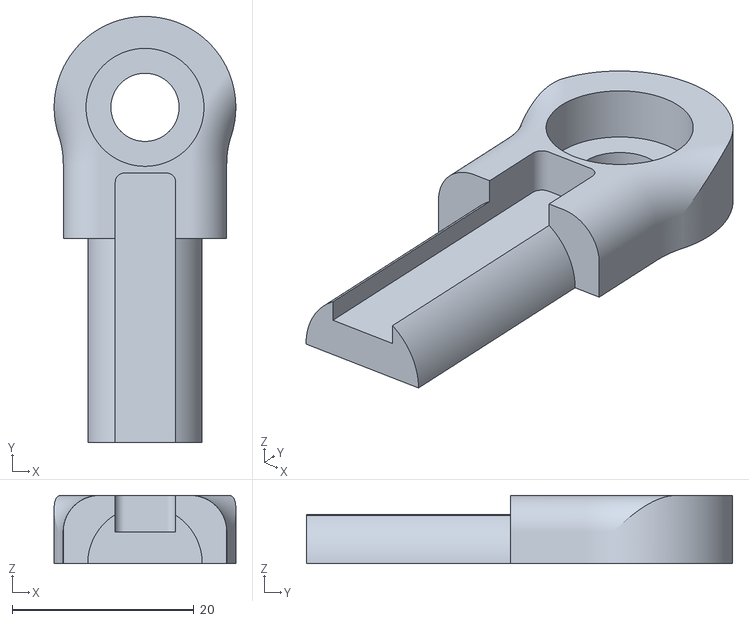
[picture p42: CAD file, 2026-10-07]
drawbot_import/obj_7_大臂接头下.STL.stl
20.0 x 46.9 x 7.50
