sigizmund993/ETZ2067/drawbot_import/obj_4_副臂拉杆200mm.STL.stl

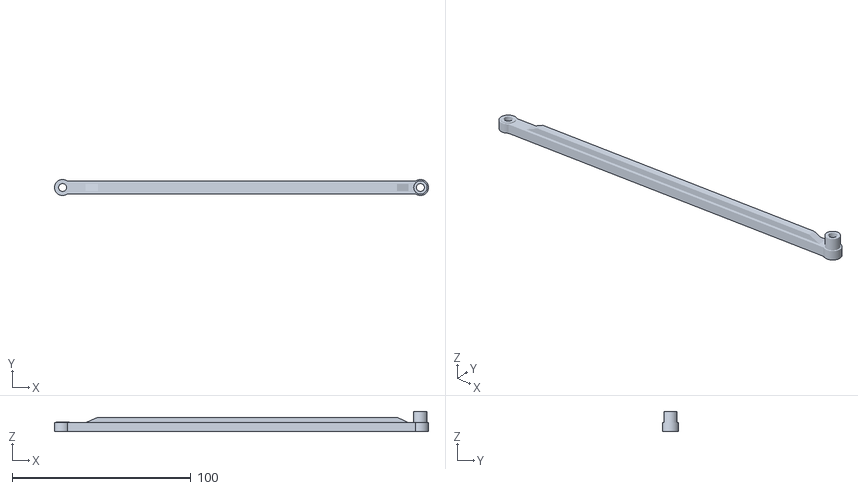
[picture p43: CAD file, 2026-10-07]
drawbot_import/obj_4_副臂拉杆200mm.STL.stl
209.0 x 9.00 x 11.4
