sigizmund993/ETZ2067/drawbot_import/obj_2_15mm_bracket_2.STL.stl

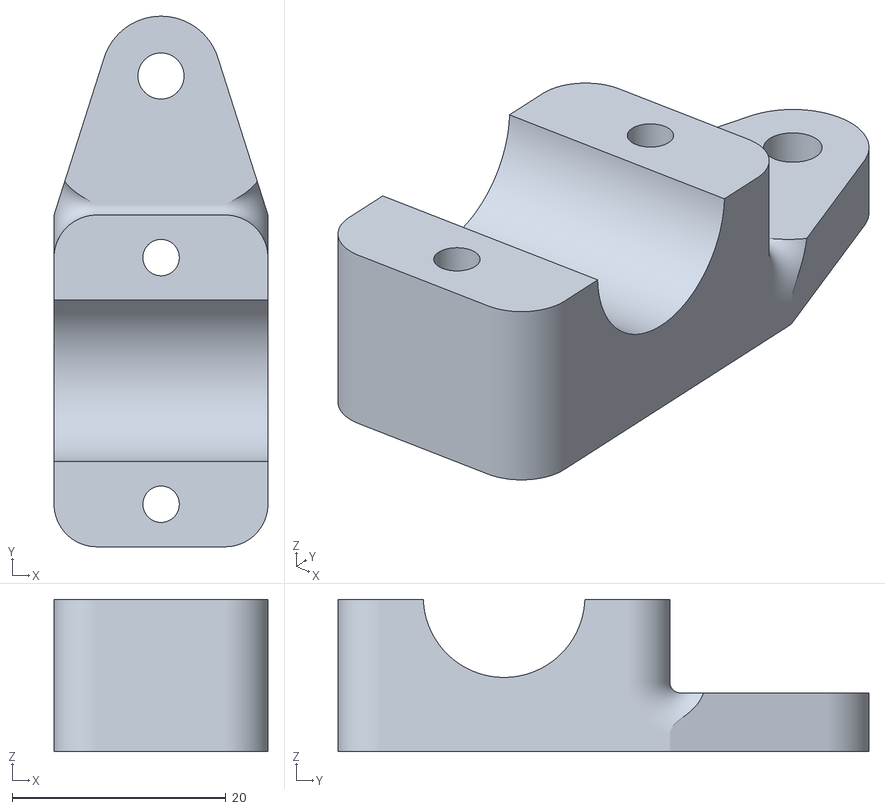
[picture p44: CAD file, 2026-10-07]
drawbot_import/obj_2_15mm_bracket_2.STL.stl
20.0 x 49.6 x 14.3
