sigizmund993/ETZ2067/(list of files, cad)

Other CAD files:
print/derzhatel_prisoski_K1C.stl
print/derzhatel_prisosok_3_K1C.stl
print/karetka_Z_P1S.stl
print/orca/derzhatel_1_K1C_enf.3mf
print/orca/derzhatel_1_enf.3mf
print/shesterni_uzla_P1S.stl
print/karetka_Z_P1S_PLA.gcode.3mf
print/orca/enforcer_derzhatel_1.stl
print/derzhatel_prisosok_3_K1C_PETG.3mf
print/derzhatel_prisoski.stl
print/derzhatel_prisoski_K2Plus.3mf
print/kronshtein_Z_K2Plus.3mf
