sigizmund993/ETZ2067/print/preview_kronshtein_Z.png

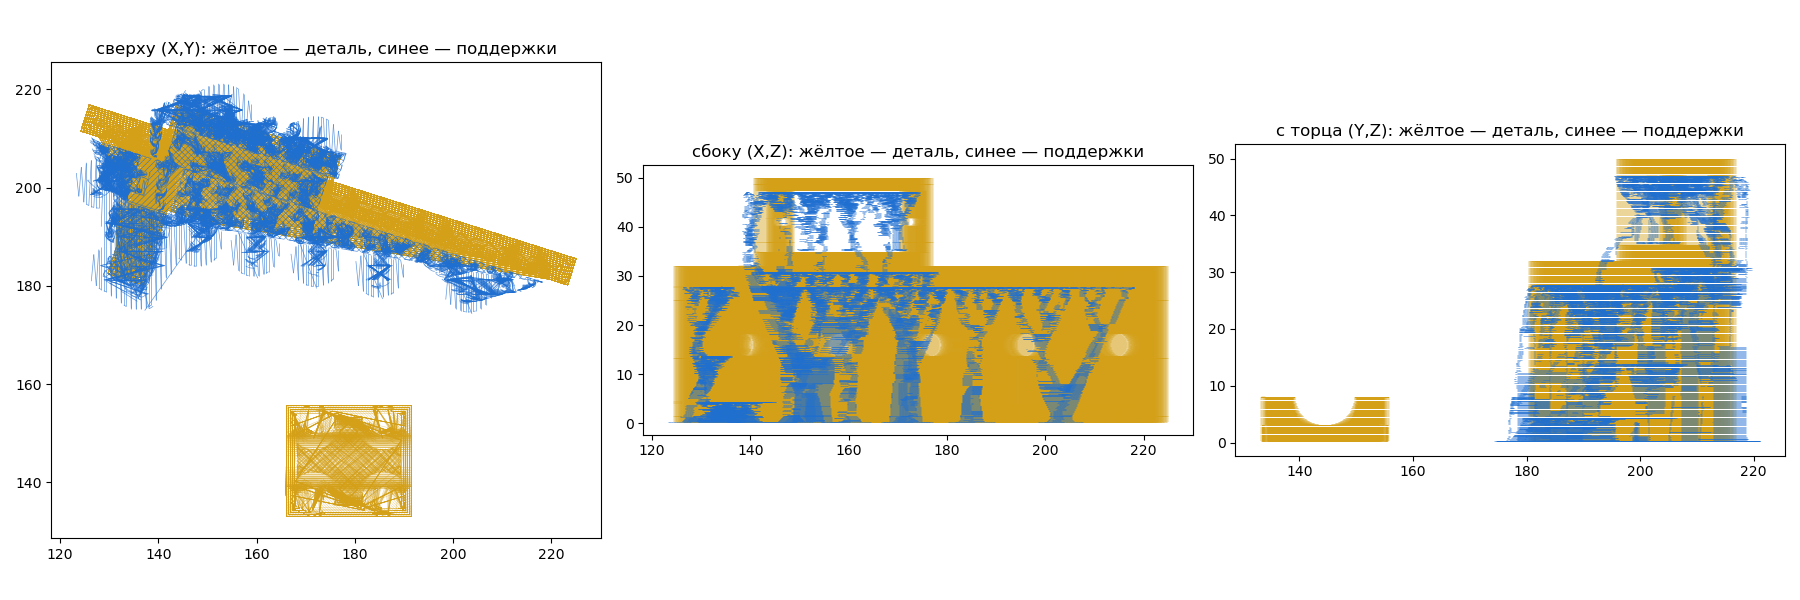
print/preview_kronshtein_Z.png
