sigizmund993/ETZ2067/elektronika/etz_plata_E3_PE3.pdf

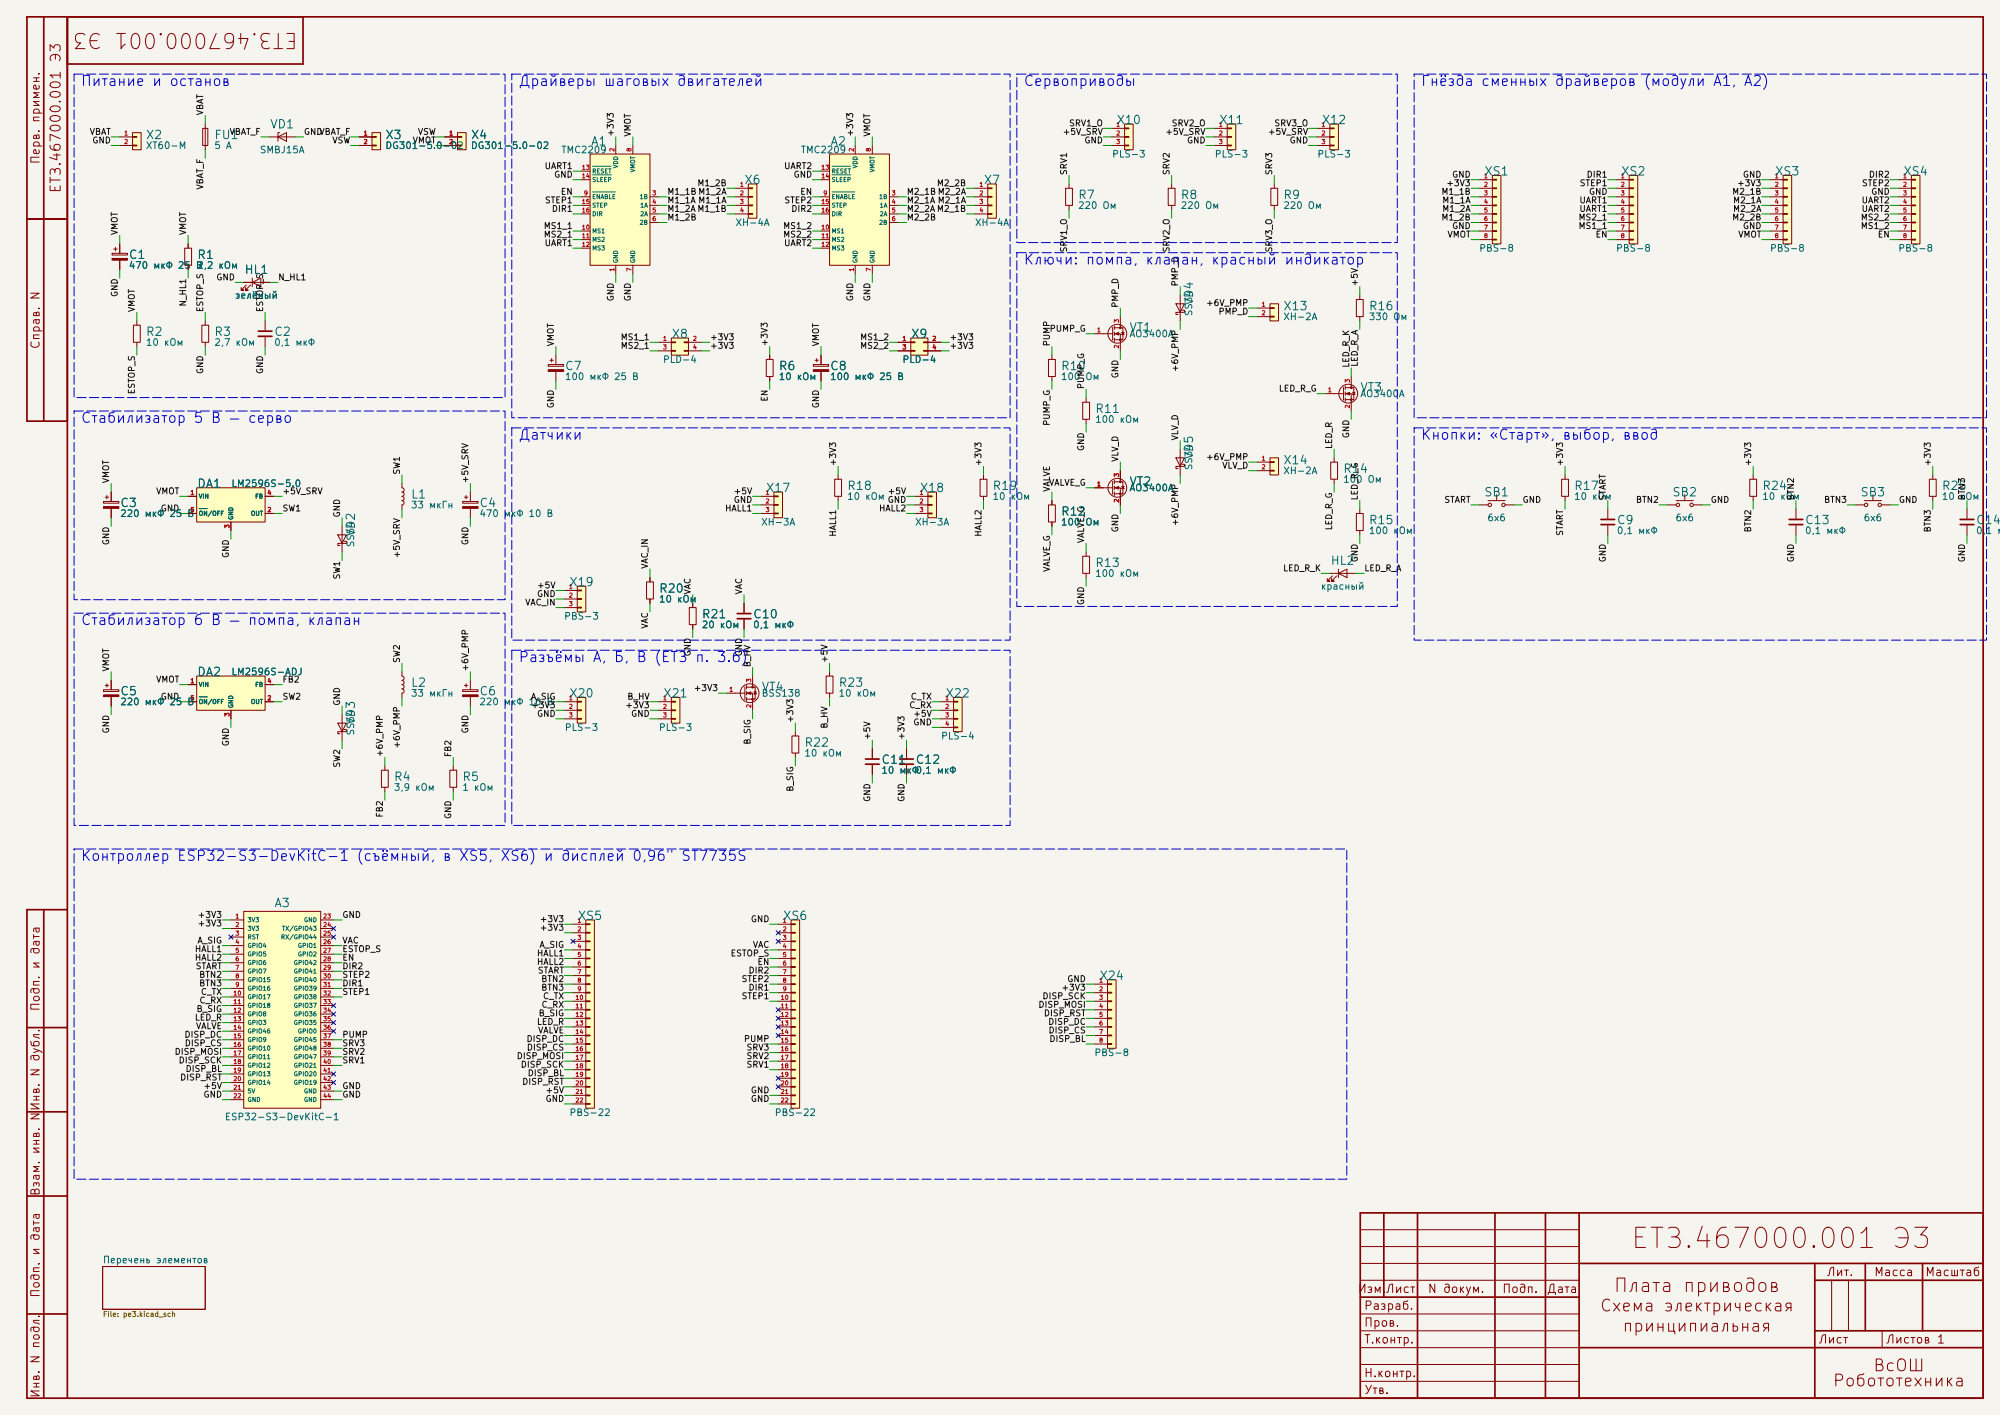
[picture p46: page 1]

Гнёзда сменных драйверов (модули A1, A2)

Ключи: помпа, клапан, красный индикатор

Кнопки: «Старт», выбор, ввод

Контроллер ESP32-S3-DevKitC-1 (съёмный, в XS5, XS6) и дисплей 0,96" ST7735S

ЕТЗ.467000.001 Э3

Плата приводов Схема электрическая принципиальная | Лит. | Масса | Масштаб

Разраб.
Пров.
Т.контр. | Лист | Листов 1

ВсОШ

Н.контр.
Утв.

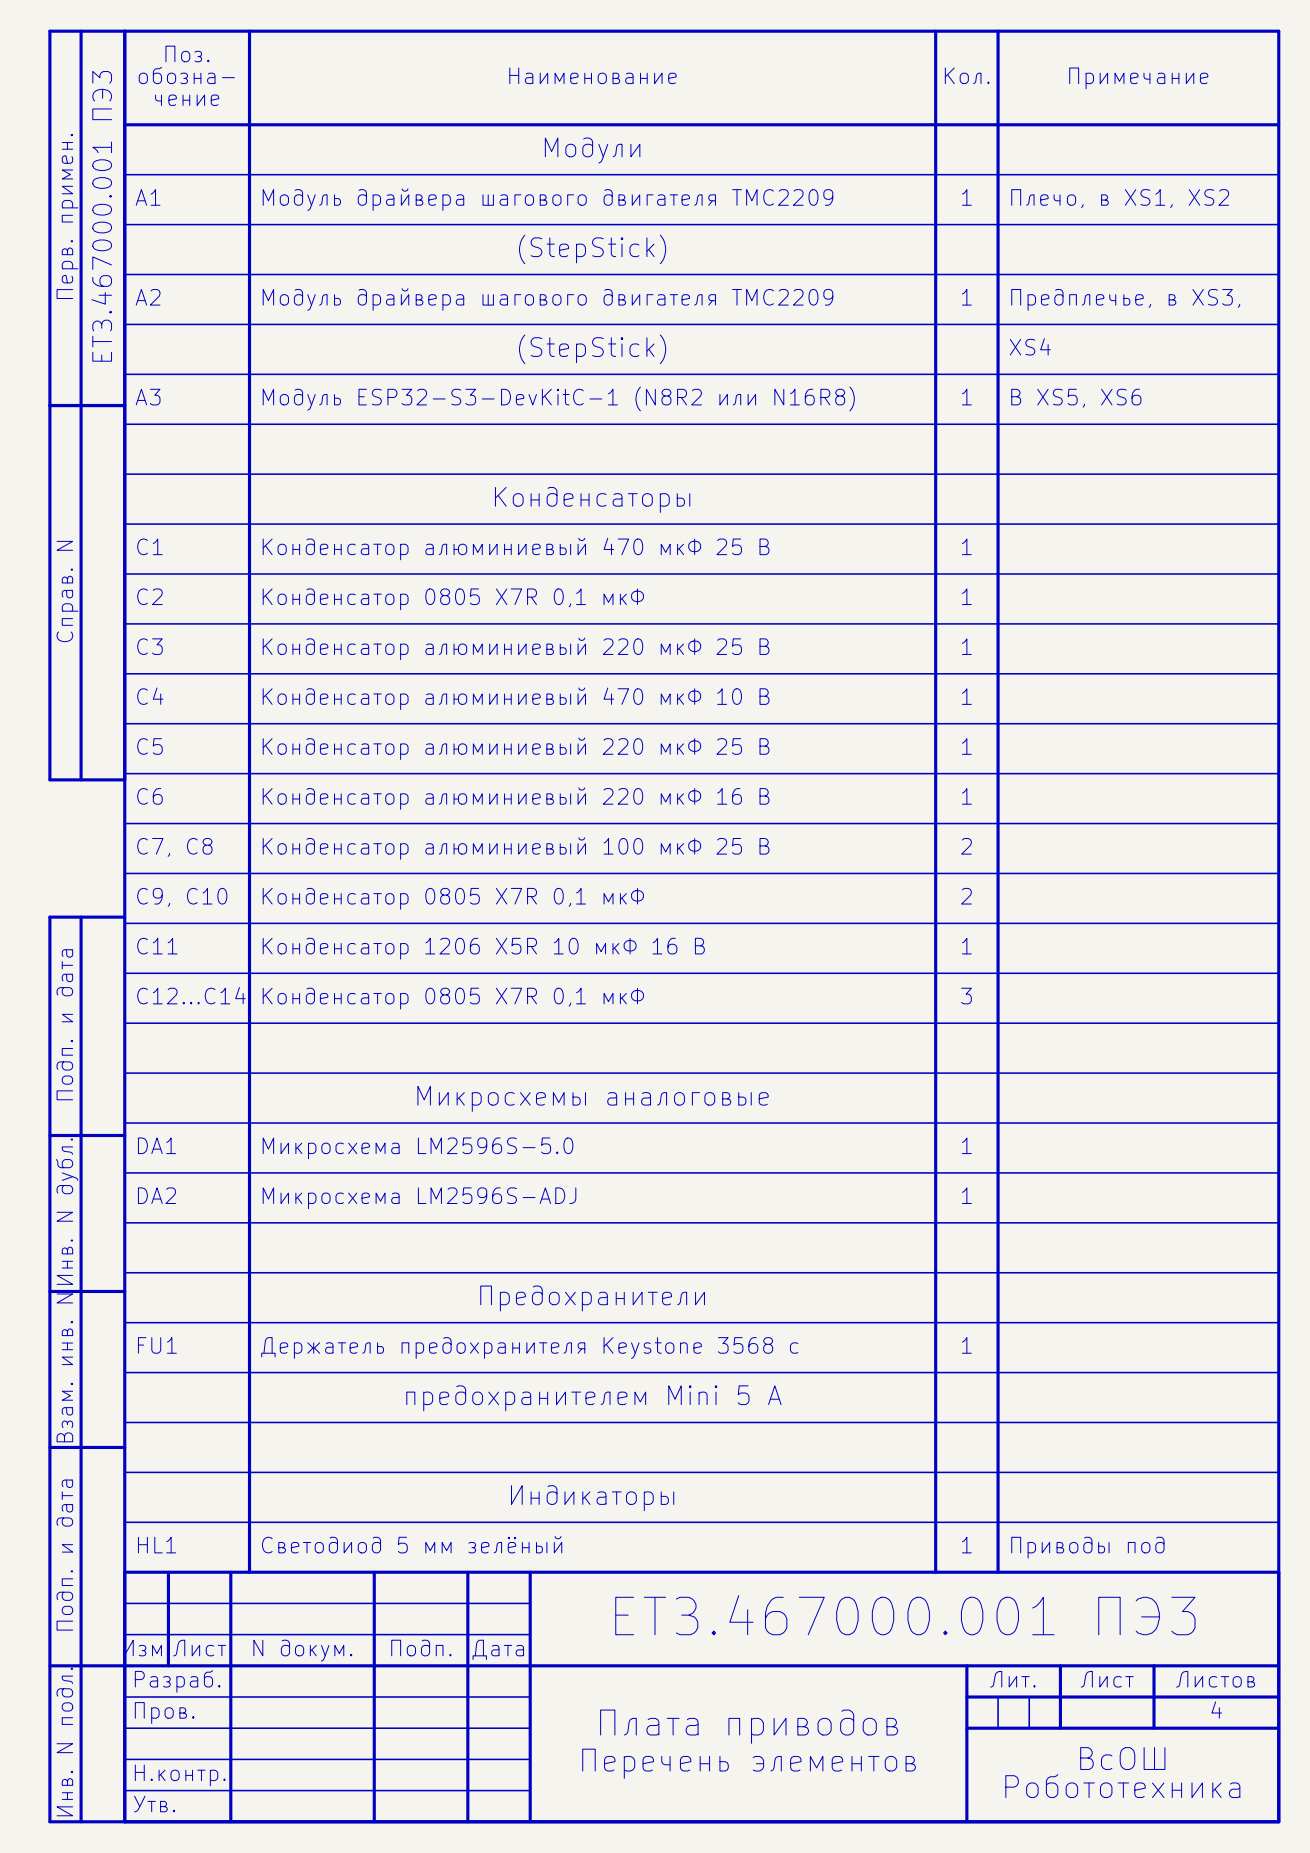
[picture p47: page 2]

Поз. обозна-чение | | | Примечание

Наименование Справ. N (StepStick)

Модули

A1 | Модуль драйвера шагового двигателя TMC2209 | 1 | Плечо, в XS1, XS2

A2 | Модуль драйвера шагового двигателя TMC2209 | 1 | Предплечье, в XS3,

(StepStick) | | XS4

A3 | Модуль ESP32-S3-DevKitC-1 (N8R2 или N16R8) | 1 | В XS5, XS6

Конденсаторы

C1 | Конденсатор алюминиевый 470 мкФ 25 В | 1

C2 | Конденсатор 0805 X7R 0,1 мкФ | 1

C3 | Конденсатор алюминиевый 220 мкФ 25 В | 1

C4 | Конденсатор алюминиевый 470 мкФ 10 В | 1

C5 | Конденсатор алюминиевый 220 мкФ 25 В | 1

C6 | Конденсатор алюминиевый 220 мкФ 16 В | 1

C7, C8 | Конденсатор алюминиевый 100 мкФ 25 В | 2

C9, C10 | Конденсатор 0805 X7R 0,1 мкФ | 2

C11 | Конденсатор 1206 X5R 10 мкФ 16 В | 1

C12…C14 | Конденсатор 0805 X7R 0,1 мкФ | 3

Микросхемы аналоговые

DA1 | Микросхема LM2596S-5.0 | 1

DA2 | Микросхема LM2596S-ADJ | 1

Предохранители

Держатель предохранителя Keystone 3568 с Подп. и дата Инв. N подл.

предохранителем Mini 5 А

Индикаторы

HL1 | Светодиод 5 мм зелёный | 1 | Приводы под

ЕТЗ.467000.001 ПЭ3

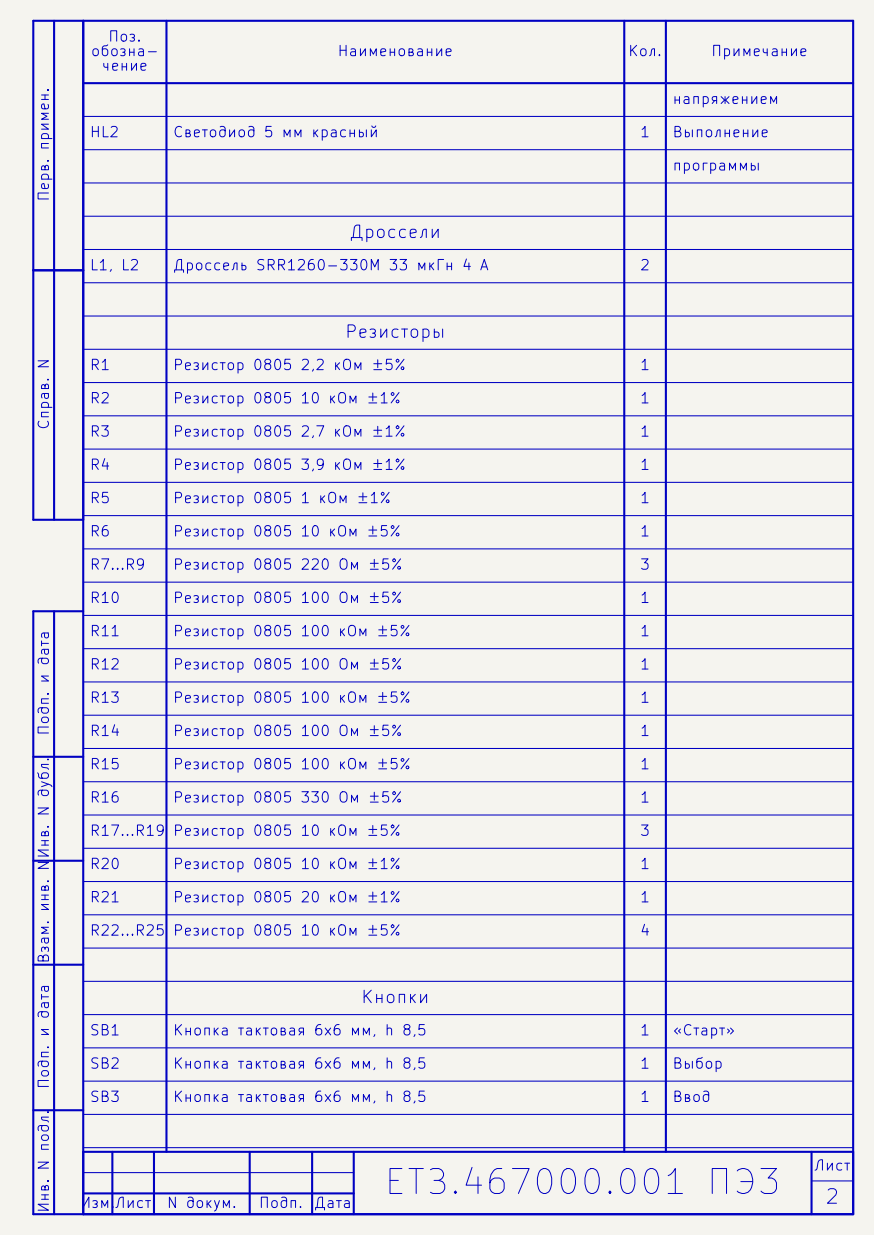
[picture p48: page 3]

Наименование | Кол.

1 Перв. примен.

напряжением

HL2 | Светодиод 5 мм красный | 1 | Выполнение

программы

Дроссели

L1, L2 | Дроссель SRR1260-330M 33 мкГн 4 А | 2
R13 Справ. N

Резисторы

R1 | Резистор 0805 2,2 кОм ±5% | 1

R2 | Резистор 0805 10 кОм ±1%

R3 | Резистор 0805 2,7 кОм ±1% | 1

R4 | Резистор 0805 3,9 кОм ±1% | 1

R5 | Резистор 0805 1 кОм ±1% | 1

R6 | Резистор 0805 10 кОм ±5% | 1

R7…R9 | Резистор 0805 220 Ом ±5% | 3

R10 | Резистор 0805 100 Ом ±5% | 1
R14 Инв. N дубл. Взам. инв. N

R11 Подп. и дата

Резистор 0805 100 кОм ±5% | 1

R12 | Резистор 0805 100 Ом ±5% | 1

Резистор 0805 100 Ом ±5% | 1

R15 | Резистор 0805 100 кОм ±5% | 1

R16 | Резистор 0805 330 Ом ±5% | 1

R17…R19 | Резистор 0805 10 кОм ±5% | 3

R20 | Резистор 0805 10 кОм ±1% | 1
SB1 Подп. и дата Инв. N подл.

R21 | Резистор 0805 20 кОм ±1% | 1

R22…R25 | Резистор 0805 10 кОм ±5% | 4

Кнопки

Кнопка тактовая 6x6 мм, h 8,5 | 1 | «Старт»

SB2 | Кнопка тактовая 6x6 мм, h 8,5 | 1 | Выбор

SB3 | Кнопка тактовая 6x6 мм, h 8,5 | 1 | Ввод

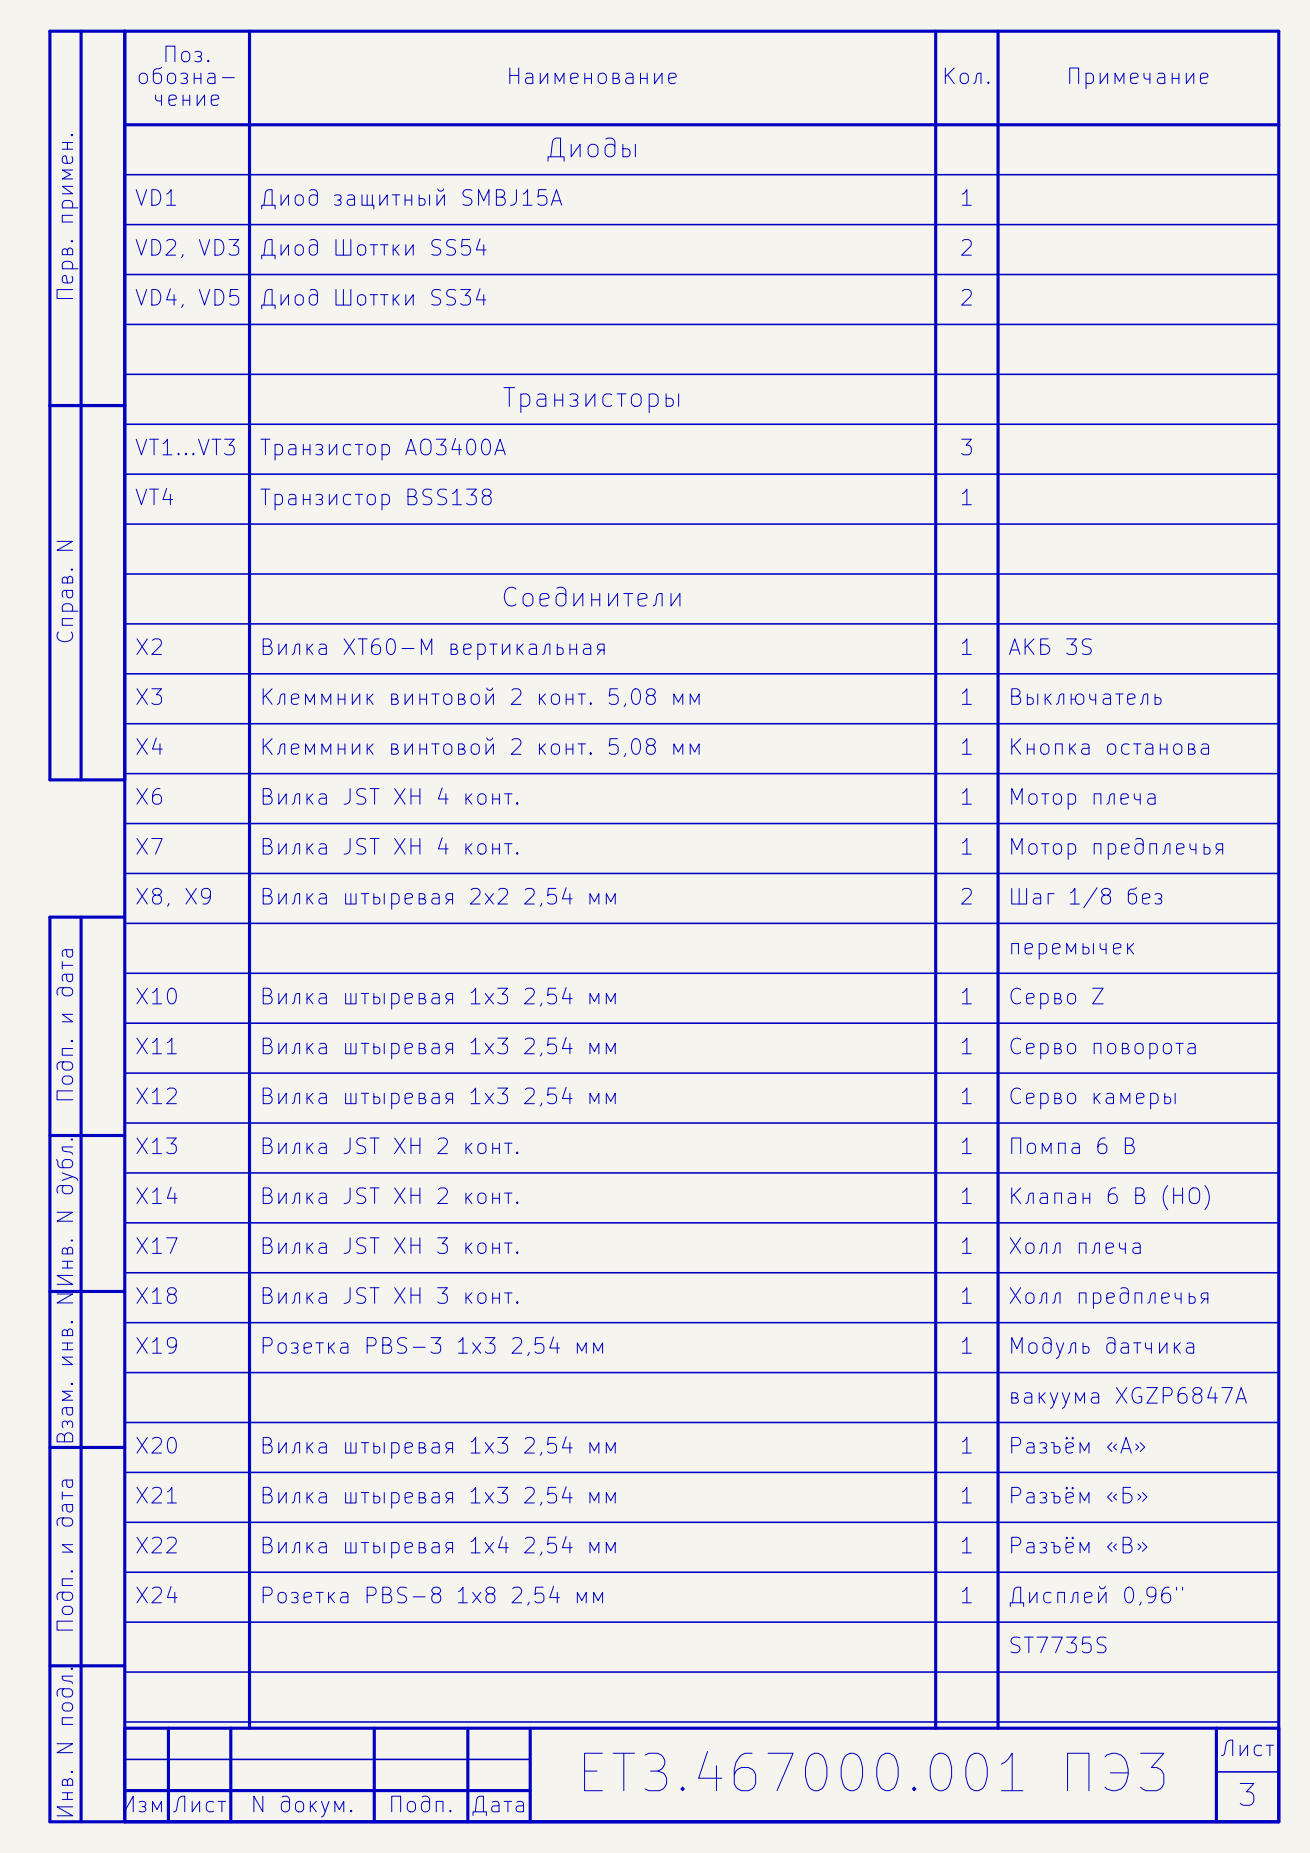
[picture p49: page 4]

Наименование | Кол.

Вилка штыревая 2x2 2,54 мм Транзисторы | 2 | Шаг 1/8 без Справ. N Перв. примен.

Диоды

VD1 | Диод защитный SMBJ15A | 1

VD2, VD3 | Диод Шоттки SS54 | 2

VD4, VD5 | Диод Шоттки SS34 | 2

VT1…VT3 | Транзистор AO3400A | 3

VT4 | Транзистор BSS138 | 1

Соединители

X2 | Вилка XT60-M вертикальная | 1 | АКБ 3S

X3 | Клеммник винтовой 2 конт. 5,08 мм | 1 | Выключатель

X4 | Клеммник винтовой 2 конт. 5,08 мм | 1 | Кнопка останова

X13 | Вилка штыревая 1x3 2,54 мм Инв. N дубл. Взам. инв. N Вилка JST XH 2 конт. | 1 1 | Мотор плеча Инв. N подл. Помпа 6 В

X6 | Вилка JST XH 4 конт.

X7 | Вилка JST XH 4 конт. | 1 | Мотор предплечья

X10 Подп. и дата

перемычек

1 | Серво Z

X11 | Вилка штыревая 1x3 2,54 мм | 1 | Серво поворота

X12 | Вилка штыревая 1x3 2,54 мм | 1 | Серво камеры

X14 | Вилка JST XH 2 конт. | 1 | Клапан 6 В (НО)

X17 | Вилка JST XH 3 конт. | 1 | Холл плеча

X18 | Вилка JST XH 3 конт. | 1 | Холл предплечья

X19 | Розетка PBS-3 1x3 2,54 мм | 1 | Модуль датчика

вакуума XGZP6847A

X20 | Вилка штыревая 1x3 2,54 мм | 1 | Разъём «А»

X21 Подп. и дата

Вилка штыревая 1x3 2,54 мм | 1 | Разъём «Б»

X22 | Вилка штыревая 1x4 2,54 мм | 1 | Разъём «В»

X24 | Розетка PBS-8 1x8 2,54 мм | 1 | Дисплей 0,96"

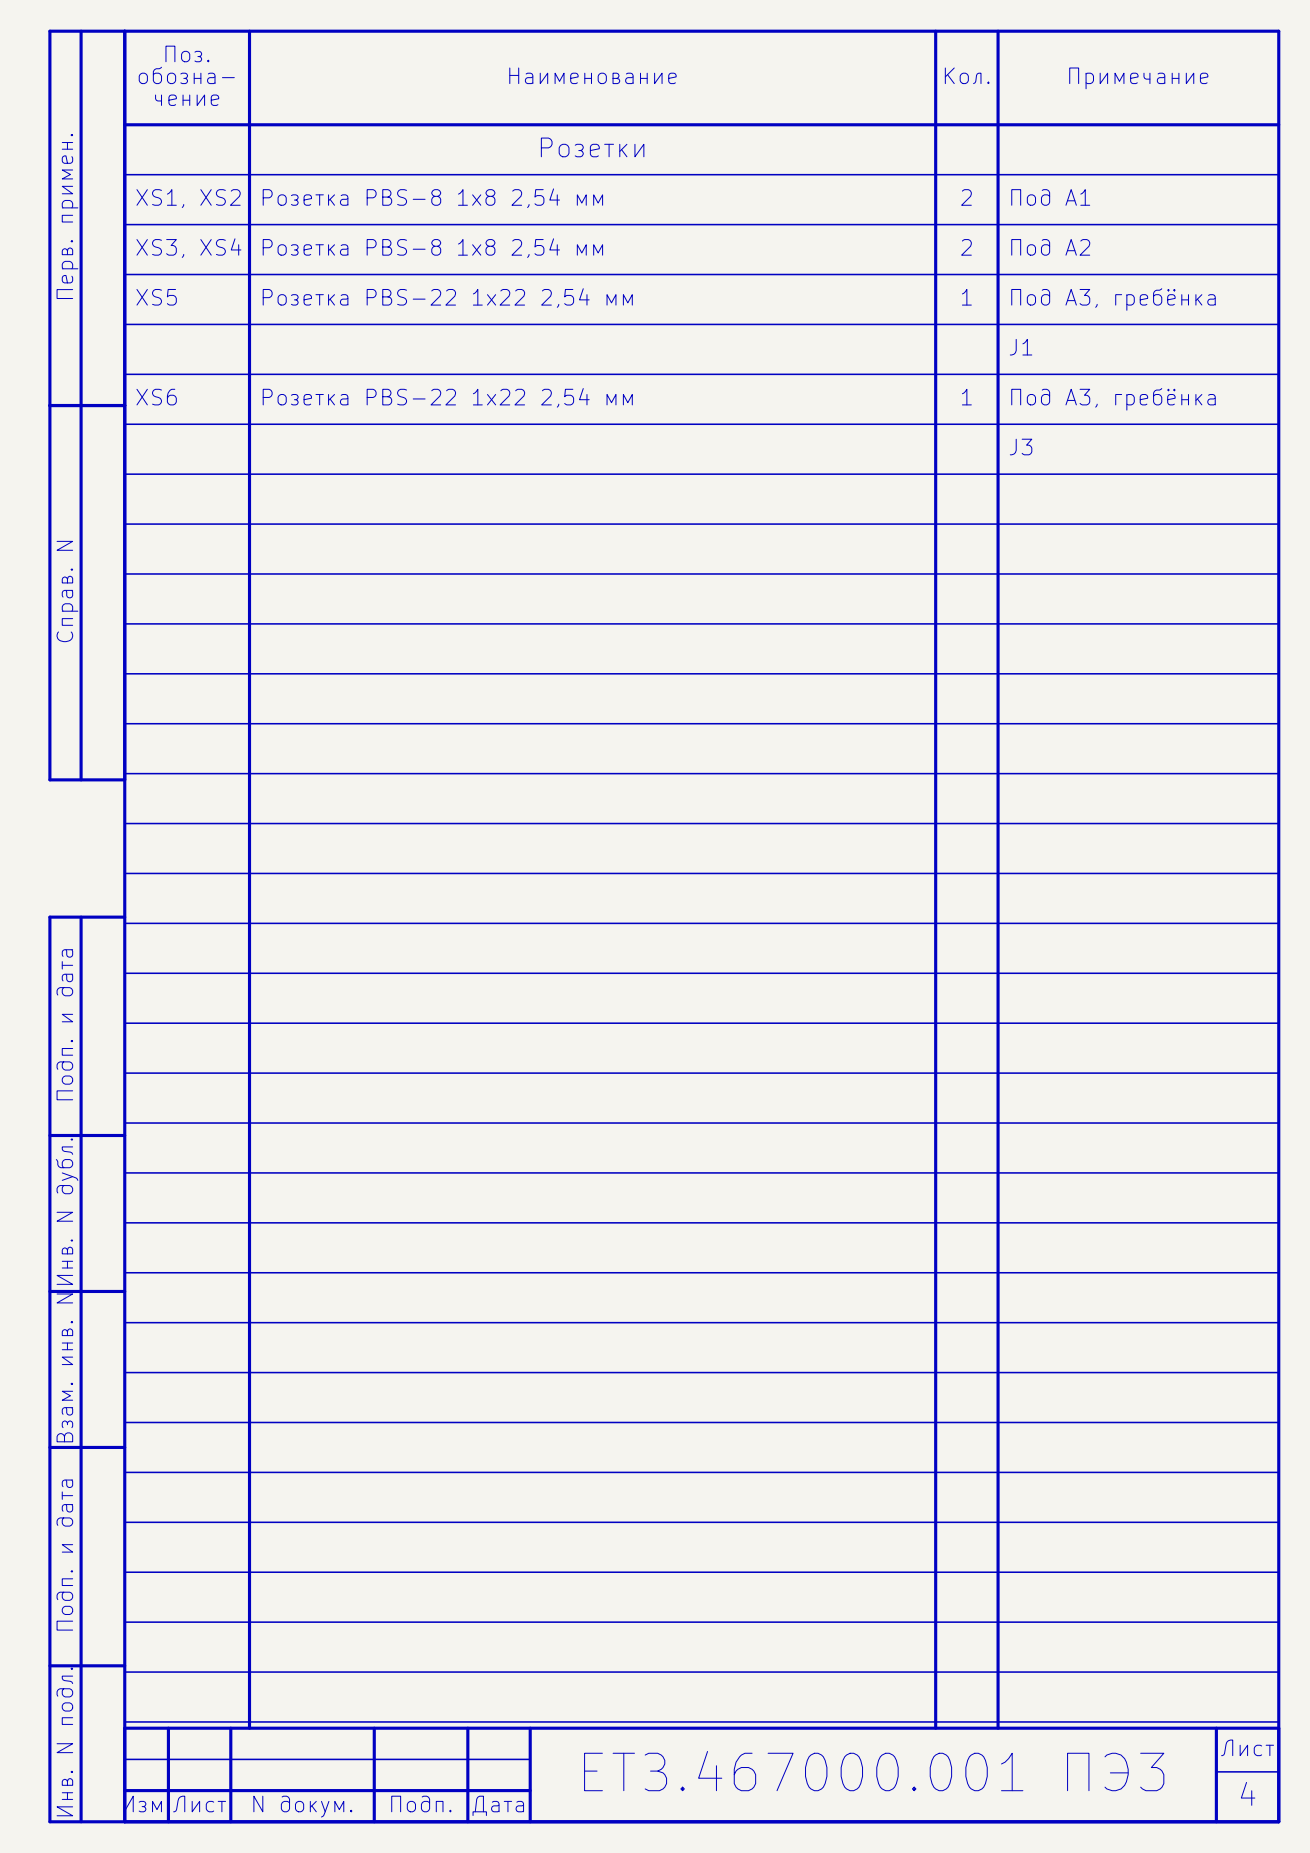
[picture p50: page 5]

Наименование | Кол.

Изм. Справ. N Перв. примен.

Розетки

XS1, XS2 | Розетка PBS-8 1x8 2,54 мм | | Под A1

XS3, XS4 | Розетка PBS-8 1x8 2,54 мм | 2 | Под A2

XS5 | Розетка PBS-22 1x22 2,54 мм | 1 | Под A3, гребёнка

XS6 | Розетка PBS-22 1x22 2,54 мм | 1 | Под A3, гребёнка
