sigizmund993/ETZ2067/elektronika/etz_plata.kicad_pcb

## KiCad design elektronika/etz_plata.kicad_pcb (2026-11-04)

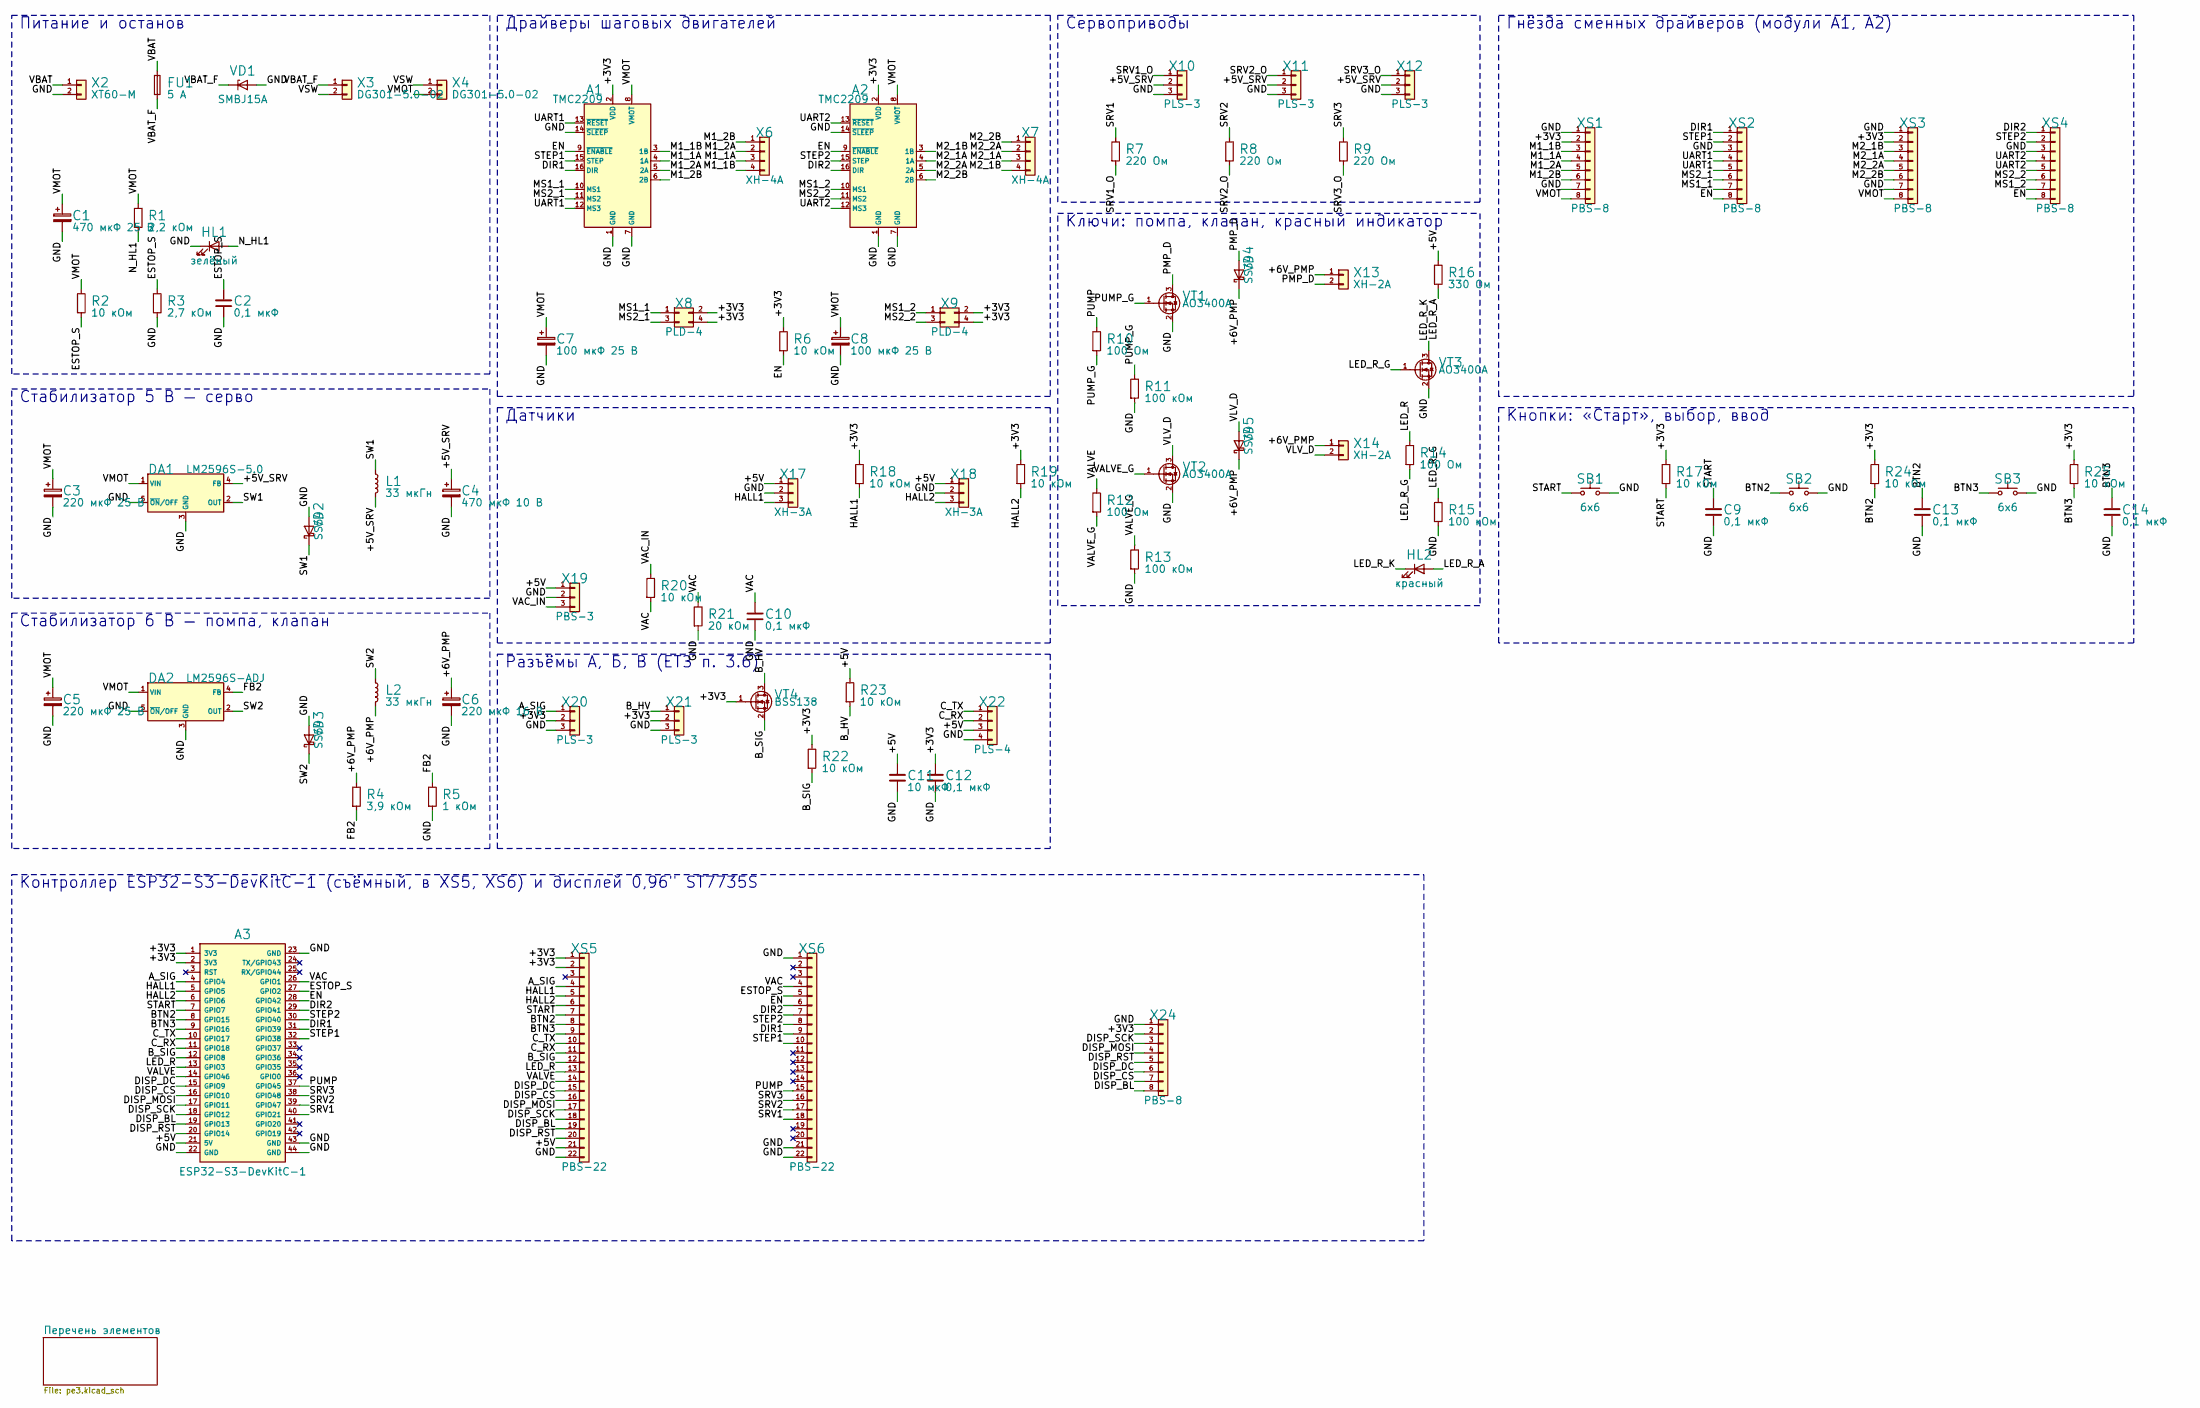
[picture p51: schematic etz_plata.kicad_sch, Плата приводов]

Parts:
A1, A2: TMC2209
A3: ESP32-S3-DevKitC-1
C1: 470 мкФ 25 В; CP_Radial_D10.0mm_P5.00mm
C2, C9, C10, C12, C13, C14: 0,1 мкФ; C_0805_2012Metric
C3, C5: 220 мкФ 25 В; CP_Radial_D8.0mm_P3.50mm
C4: 470 мкФ 10 В; CP_Radial_D8.0mm_P3.50mm
C6: 220 мкФ 16 В; CP_Radial_D8.0mm_P3.50mm
C7, C8: 100 мкФ 25 В; CP_Radial_D6.3mm_P2.50mm
C11: 10 мкФ; C_1206_3216Metric
DA1: LM2596S-5.0; TO-263-5_TabPin3
DA2: LM2596S-ADJ; TO-263-5_TabPin3
FU1: 5 А; Fuseholder_Blade_Mini_Keystone_3568
HL1: зелёный; LED_D5.0mm
HL2: красный; LED_D5.0mm
L1, L2: 33 мкГн; L_Bourns_SRR1260
R1: 2,2 кОм; R_0805_2012Metric
R2, R6, R17, R18, R19, R20, R22, R23, R24, R25: 10 кОм; R_0805_2012Metric
R3: 2,7 кОм; R_0805_2012Metric
R4: 3,9 кОм; R_0805_2012Metric
R5: 1 кОм; R_0805_2012Metric
R7, R8, R9: 220 Ом; R_0805_2012Metric
R10, R12, R14: 100 Ом; R_0805_2012Metric
R11, R13, R15: 100 кОм; R_0805_2012Metric
R16: 330 Ом; R_0805_2012Metric
R21: 20 кОм; R_0805_2012Metric
SB1, SB2, SB3: 6x6; SW_PUSH_6mm_H8.5mm
VD1: SMBJ15A; D_SMB
VD2, VD3: SS54; D_SMC
VD4, VD5: SS34; D_SMA
VT1, VT2, VT3: AO3400A; SOT-23
VT4: BSS138; SOT-23
X2: XT60-M; AMASS_XT60-M_1x02_P7.20mm_Vertical
X3, X4: DG301-5.0-02; TerminalBlock_Phoenix_MKDS-1,5-2-5.08_1x02_P5.08mm_Horizont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
X6, X7: XH-4A; JST_XH_B4B-XH-A_1x04_P2.50mm_Vertical
X8, X9: PLD-4; PinHeader_2x02_P2.54mm_Vertical
X10, X11, X12, X20, X21: PLS-3; PinHeader_1x03_P2.54mm_Vertical
X13, X14: XH-2A; JST_XH_B2B-XH-A_1x02_P2.50mm_Vertical
X17, X18: XH-3A; JST_XH_B3B-XH-A_1x03_P2.50mm_Vertical
X19: PBS-3; PinSocket_1x03_P2.54mm_Vertical
X22: PLS-4; PinHeader_1x04_P2.54mm_Vertical
X24: PBS-8; PinSocket_1x08_P2.54mm_Vertical
XS1, XS2, XS3, XS4: PBS-8; PinSocket_1x08_P2.54mm_Vertical
XS5, XS6: PBS-22; PinSocket_1x22_P2.54mm_Vertical

Connections:
/+3V3: A1.2 (VDD), A2.2 (VDD), A3.1 (3V3), A3.2 (3V3), C12.1, R6.1, R17.1, R18.1, R19.1, R22.1, R24.1, R25.1, VT4.1 (G), X8.2, X8.4, X9.2, X9.4, X20.2, X21.2, X24.2, XS1.2, XS3.2, XS5.1, XS5.2
/+5V: A3.21 (5V), C11.1, R16.1, R23.1, X17.1, X18.1, X19.1, X22.3, XS5.21
/+5V_SRV: C4.1, DA1.4 (FB), L1.2, X10.2, X11.2, X12.2
/+6V_PMP: C6.1, L2.2, R4.1, VD4.1 (K), VD5.1 (K), X13.1, X14.1
/A_SIG: A3.4 (GPIO4), X20.1, XS5.4
/BTN2: A3.8 (GPIO15), C13.1, R24.2, SB2.1, XS5.8
/BTN3: A3.9 (GPIO16), C14.1, R25.2, SB3.1, XS5.9
/B_HV: R23.2, VT4.3 (D), X21.1
/B_SIG: A3.12 (GPIO8), R22.2, VT4.2 (S), XS5.12
/C_RX: A3.11 (GPIO18), X22.2, XS5.11
/C_TX: A3.10 (GPIO17), X22.1, XS5.10
/DIR1: A1.16 (DIR), A3.31 (GPIO39), XS2.1, XS6.9
/DIR2: A2.16 (DIR), A3.29 (GPIO41), XS4.1, XS6.7
/DISP_BL: A3.19 (GPIO13), X24.8, XS5.19
/DISP_CS: A3.16 (GPIO10), X24.7, XS5.16
/DISP_DC: A3.15 (GPIO9), X24.6, XS5.15
/DISP_MOSI: A3.17 (GPIO11), X24.4, XS5.17
/DISP_RST: A3.20 (GPIO14), X24.5, XS5.20
/DISP_SCK: A3.18 (GPIO12), X24.3, XS5.18
/EN: A1.9 (~ENABLE), A2.9 (~ENABLE), A3.28 (GPIO42), R6.2, XS2.8, XS4.8, XS6.6
/ESTOP_S: A3.27 (GPIO2), C2.1, R2.2, R3.1, XS6.5
/FB2: DA2.4 (FB), R4.2, R5.1
/GND: A1.1 (GND), A1.7 (GND), A1.14 (~SLEEP), A2.1 (GND), A2.7 (GND), A2.14 (~SLEEP), A3.22 (GND), A3.23 (GND), A3.43 (GND), A3.44 (GND), C1.2, C2.2, C3.2, C4.2, C5.2, C6.2, C7.2, C8.2, C9.2, C10.2, C11.2, C12.2, C13.2, C14.2, DA1.3 (GND), DA1.5 (~ON/OFF), DA2.3 (GND), DA2.5 (~ON/OFF), HL1.1 (K), R3.2, R5.2, R11.2, R13.2, R15.2, R21.2, SB1.2, SB2.2, SB3.2, VD1.2 (A), VD2.2 (A), VD3.2 (A), VT1.2 (S), VT2.2 (S), VT3.2 (S), X2.2, X10.3, X11.3, X12.3, X17.2, X18.2, X19.2, X20.3, X21.3, X22.4, X24.1, XS1.1, XS1.7, XS2.3, XS3.1, XS3.7, XS4.3, XS5.22, XS6.1, XS6.21, XS6.22
/HALL1: A3.5 (GPIO5), R18.2, X17.3, XS5.5
/HALL2: A3.6 (GPIO6), R19.2, X18.3, XS5.6
/LED_R: A3.13 (GPIO3), R14.1, XS5.13
/LED_R_A: HL2.2 (A), R16.2
/LED_R_G: R14.2, R15.1, VT3.1 (G)
/LED_R_K: HL2.1 (K), VT3.3 (D)
/M1_1A: A1.4 (1A), X6.3, XS1.4
/M1_1B: A1.3 (1B), X6.4, XS1.3
/M1_2A: A1.5 (2A), X6.2, XS1.5
/M1_2B: A1.6 (2B), X6.1, XS1.6
/M2_1A: A2.4 (1A), X7.3, XS3.4
/M2_1B: A2.3 (1B), X7.4, XS3.3
/M2_2A: A2.5 (2A), X7.2, XS3.5
/M2_2B: A2.6 (2B), X7.1, XS3.6
/MS1_1: A1.10 (MS1), X8.1, XS2.7
/MS1_2: A2.10 (MS1), X9.1, XS4.7
/MS2_1: A1.11 (MS2), X8.3, XS2.6
/MS2_2: A2.11 (MS2), X9.3, XS4.6
/N_HL1: HL1.2 (A), R1.2
/PMP_D: VD4.2 (A), VT1.3 (D), X13.2
/PUMP: A3.37 (GPIO45), R10.1, XS6.15
/PUMP_G: R10.2, R11.1, VT1.1 (G)
/SRV1: A3.40 (GPIO21), R7.1, XS6.18
/SRV1_O: R7.2, X10.1
/SRV2: A3.39 (GPIO47), R8.1, XS6.17
/SRV2_O: R8.2, X11.1
/SRV3: A3.38 (GPIO48), R9.1, XS6.16
/SRV3_O: R9.2, X12.1
/START: A3.7 (GPIO7), C9.1, R17.2, SB1.1, XS5.7
/STEP1: A1.15 (STEP), A3.32 (GPIO38), XS2.2, XS6.10
/STEP2: A2.15 (STEP), A3.30 (GPIO40), XS4.2, XS6.8
/SW1: DA1.2 (OUT), L1.1, VD2.1 (K)
/SW2: DA2.2 (OUT), L2.1, VD3.1 (K)
/UART1: A1.12 (MS3), A1.13 (~RESET), XS2.4, XS2.5
/UART2: A2.12 (MS3), A2.13 (~RESET), XS4.4, XS4.5
/VAC: A3.26 (GPIO1), C10.1, R20.2, R21.1, XS6.4
/VAC_IN: R20.1, X19.3
/VALVE: A3.14 (GPIO46), R12.1, XS5.14
/VALVE_G: R12.2, R13.1, VT2.1 (G)
/VBAT: FU1.1, X2.1
/VBAT_F: FU1.2, VD1.1 (K), X3.1
/VLV_D: VD5.2 (A), VT2.3 (D), X14.2
/VMOT: A1.8 (VMOT), A2.8 (VMOT), C1.1, C3.1, C5.1, C7.1, C8.1, DA1.1 (VIN), DA2.1 (VIN), R1.1, R2.1, X4.2, XS1.8, XS3.8
/VSW: X3.2, X4.1

Notes on the sheet:
Питание и останов
Стабилизатор 5 В — серво
Стабилизатор 6 В — помпа, клапан
Драйверы шаговых двигателей
Сервоприводы
Датчики
Разъёмы А, Б, В (ЕТЗ п. 3.6)
Ключи: помпа, клапан, красный индикатор
Гнёзда сменных драйверов (модули A1, A2)
Кнопки: «Старт», выбор, ввод
Контроллер ESP32-S3-DevKitC-1 (съёмный, в XS5, XS6) и дисплей 0,96" ST7735S

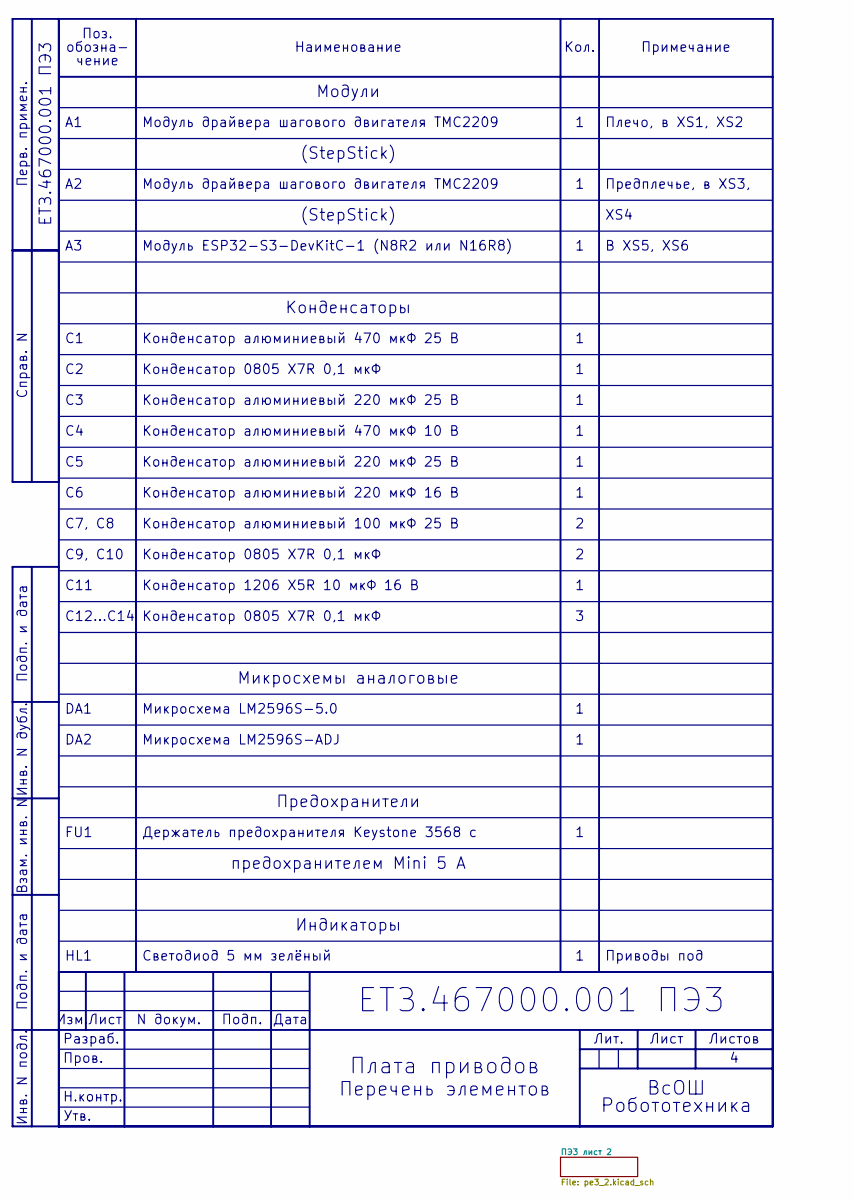
[picture p52: schematic pe3.kicad_sch]

Notes on the sheet:
Изм.
Лист
N докум.
Подп.
Дата
Разраб.
Пров.
Н.контр.
Утв.
Лит.
Листов
ЕТЗ.467000.001 ПЭ3
Плата приводов
Перечень элементов
ВсОШ
Робототехника
Инв. N подл.
Подп. и дата
Взам. инв. N
Инв. N дубл.
Перв. примен.
Справ. N
Поз.
обозна-
чение
Наименование
Кол.
Примечание
Модули
Модуль драйвера шагового двигателя TMC2209
Плечо, в XS1, XS2
(StepStick)
Предплечье, в XS3,
XS4
Модуль ESP32-S3-DevKitC-1 (N8R2 или N16R8)
В XS5, XS6
Конденсаторы
Конденсатор алюминиевый 470 мкФ 25 В
Конденсатор 0805 X7R 0,1 мкФ
Конденсатор алюминиевый 220 мкФ 25 В
Конденсатор алюминиевый 470 мкФ 10 В
Конденсатор алюминиевый 220 мкФ 16 В
C7, C8
Конденсатор алюминиевый 100 мкФ 25 В
C9, C10
C11
Конденсатор 1206 X5R 10 мкФ 16 В
C12…C14
Микросхемы аналоговые
DA1
Микросхема LM2596S-5.0
DA2
Микросхема LM2596S-ADJ
Предохранители
FU1
Держатель предохранителя Keystone 3568 с
предохранителем Mini 5 А
Индикаторы
HL1
Светодиод 5 мм зелёный
Приводы под

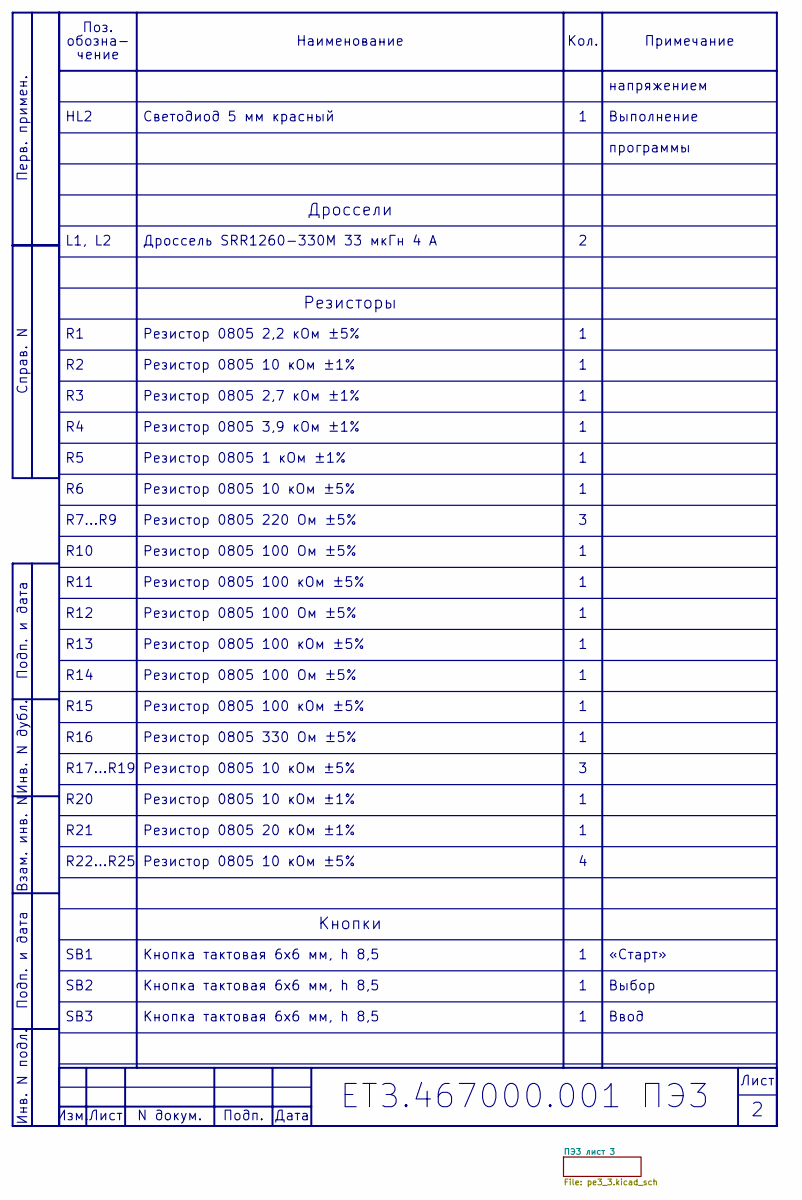
[picture p53: schematic pe3_2.kicad_sch]

Notes on the sheet:
Изм.
Лист
N докум.
Подп.
Дата
ЕТЗ.467000.001 ПЭ3
Инв. N подл.
Подп. и дата
Взам. инв. N
Инв. N дубл.
Перв. примен.
Справ. N
Поз.
обозна-
чение
Наименование
Кол.
Примечание
напряжением
HL2
Светодиод 5 мм красный
Выполнение
программы
Дроссели
L1, L2
Дроссель SRR1260-330M 33 мкГн 4 А
Резисторы
Резистор 0805 2,2 кОм ±5%
Резистор 0805 10 кОм ±1%
Резистор 0805 2,7 кОм ±1%
Резистор 0805 3,9 кОм ±1%
Резистор 0805 1 кОм ±1%
Резистор 0805 10 кОм ±5%
R7…R9
Резистор 0805 220 Ом ±5%
R10
Резистор 0805 100 Ом ±5%
R11
Резистор 0805 100 кОм ±5%
R12
R13
R14
R15
R16
Резистор 0805 330 Ом ±5%
R17…R19
R20
R21
Резистор 0805 20 кОм ±1%
R22…R25
Кнопки
SB1
Кнопка тактовая 6x6 мм, h 8,5
«Старт»
SB2
Выбор
SB3
Ввод

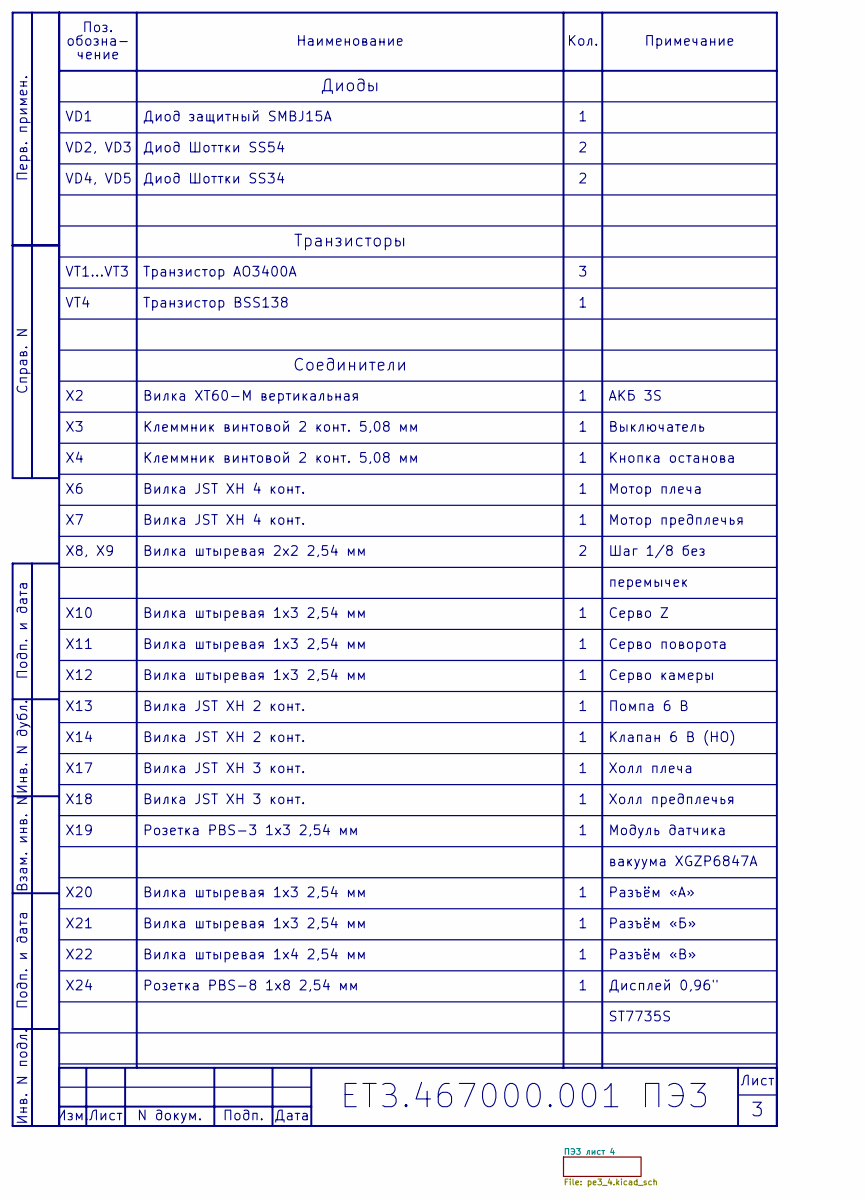
[picture p54: schematic pe3_3.kicad_sch]

Notes on the sheet:
Изм.
Лист
N докум.
Подп.
Дата
ЕТЗ.467000.001 ПЭ3
Инв. N подл.
Подп. и дата
Взам. инв. N
Инв. N дубл.
Перв. примен.
Справ. N
Поз.
обозна-
чение
Наименование
Кол.
Примечание
Диоды
VD1
Диод защитный SMBJ15A
VD2, VD3
Диод Шоттки SS54
VD4, VD5
Диод Шоттки SS34
Транзисторы
VT1…VT3
Транзистор AO3400A
VT4
Транзистор BSS138
Соединители
Вилка XT60-M вертикальная
АКБ 3S
Клеммник винтовой 2 конт. 5,08 мм
Выключатель
Кнопка останова
Вилка JST XH 4 конт.
Мотор плеча
Мотор предплечья
X8, X9
Вилка штыревая 2x2 2,54 мм
Шаг 1/8 без
перемычек
X10
Вилка штыревая 1x3 2,54 мм
Серво Z
X11
Серво поворота
X12
Серво камеры
X13
Вилка JST XH 2 конт.
Помпа 6 В
X14
Клапан 6 В (НО)
X17
Вилка JST XH 3 конт.
Холл плеча
X18
Холл предплечья
X19
Розетка PBS-3 1x3 2,54 мм
Модуль датчика
вакуума XGZP6847A
X20
Разъём «А»
X21
Разъём «Б»
X22
Вилка штыревая 1x4 2,54 мм
Разъём «В»
X24
Розетка PBS-8 1x8 2,54 мм
Дисплей 0,96"
ST7735S

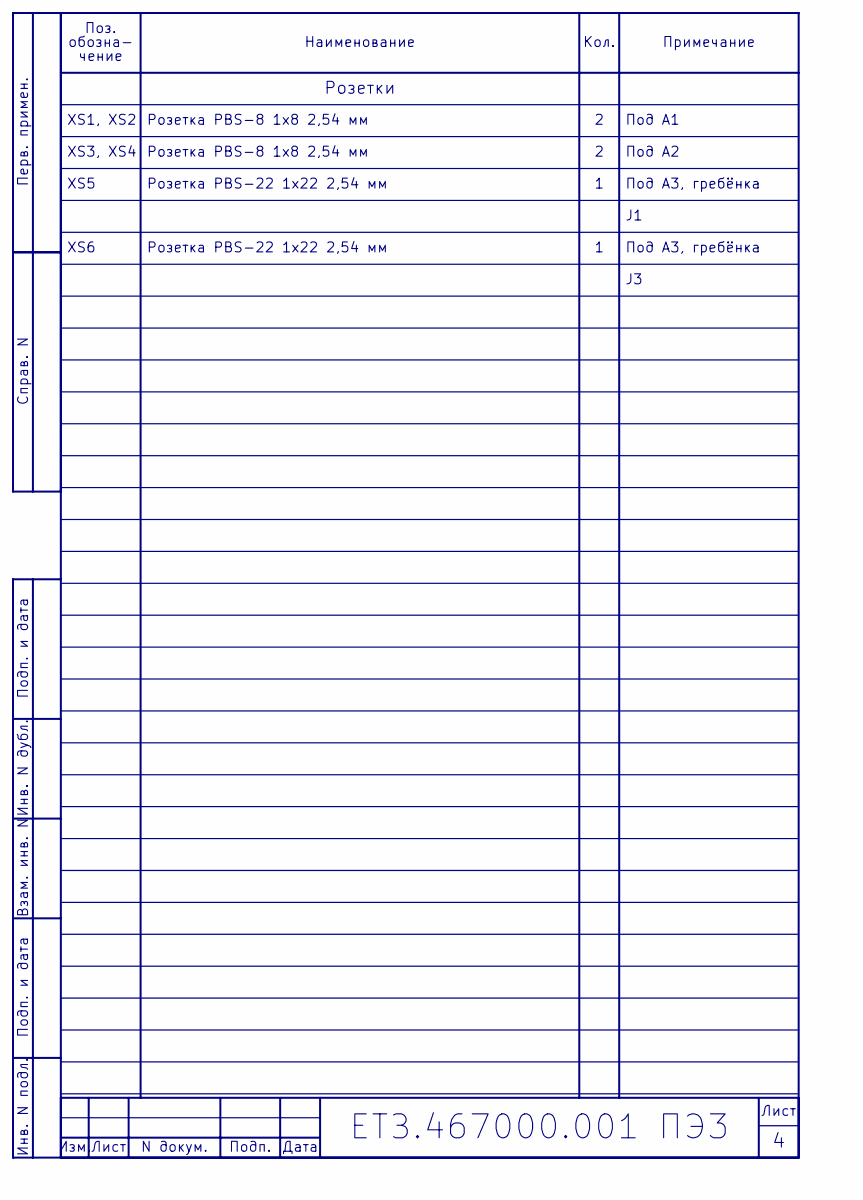
[picture p55: schematic pe3_4.kicad_sch]

Notes on the sheet:
Изм.
Лист
N докум.
Подп.
Дата
ЕТЗ.467000.001 ПЭ3
Инв. N подл.
Подп. и дата
Взам. инв. N
Инв. N дубл.
Перв. примен.
Справ. N
Поз.
обозна-
чение
Наименование
Кол.
Примечание
Розетки
XS1, XS2
Розетка PBS-8 1x8 2,54 мм
Под A1
XS3, XS4
Под A2
XS5
Розетка PBS-22 1x22 2,54 мм
Под A3, гребёнка
XS6

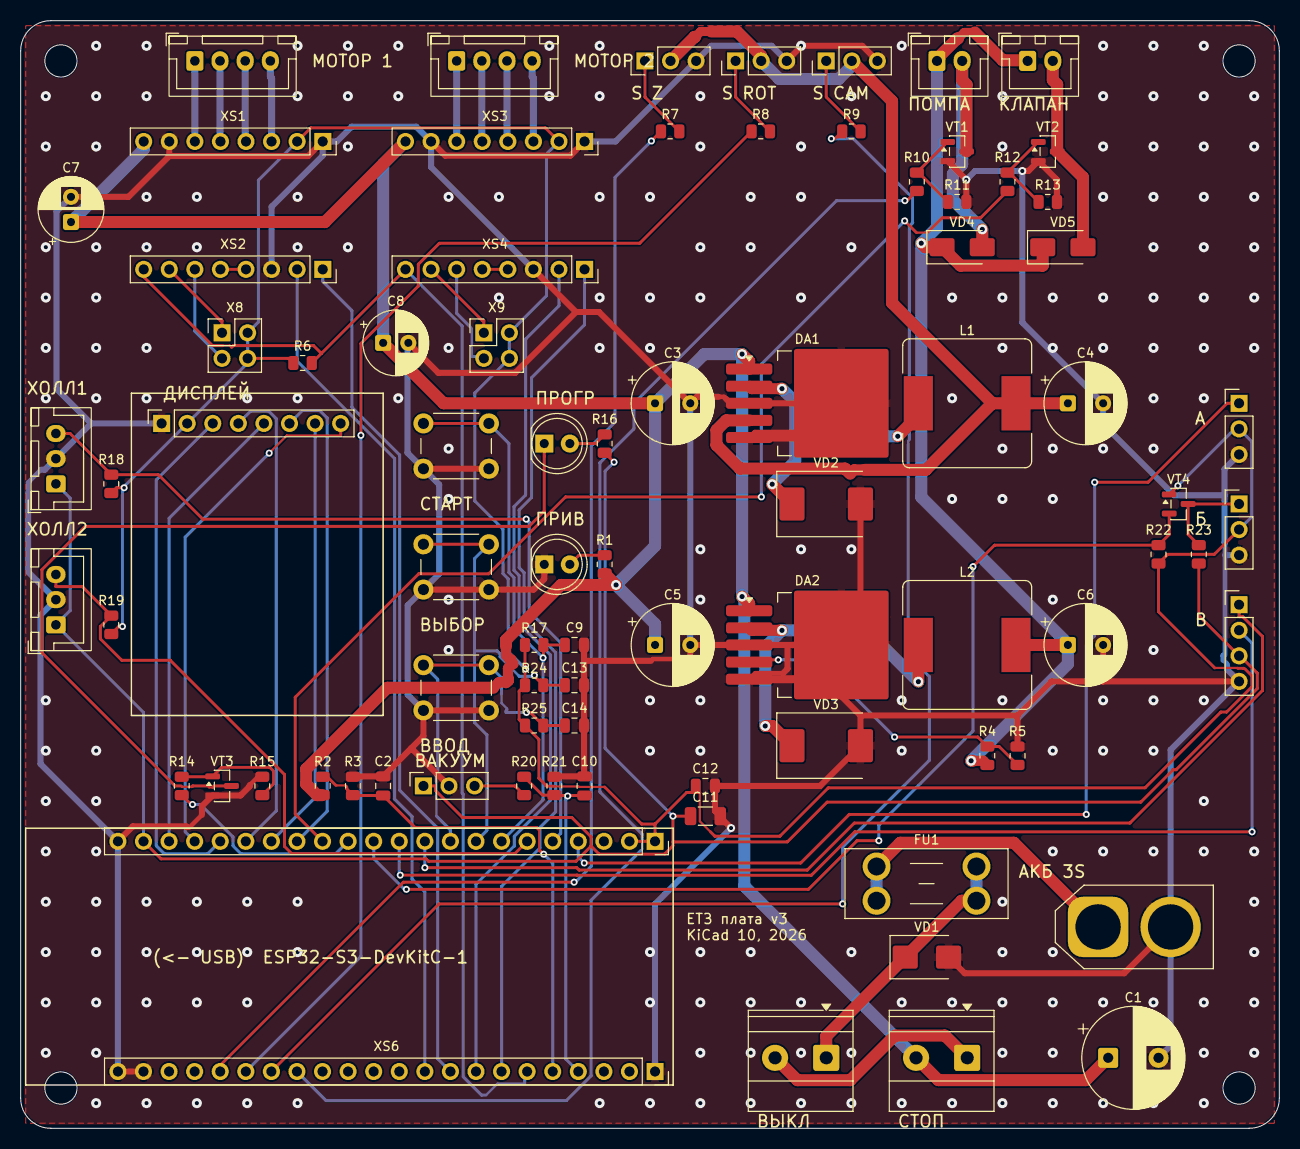
[picture p56: board etz_plata.kicad_pcb from above]

Board: 2 copper layers, 125.0 x 110.0 mm, 87 parts (0 on the bottom side), 67 nets.

Other parts of the board:
H1, H2, H3, H4: M3; MountingHole_3.2mm_M3
