sigizmund993/ETZ2067/elektronika/gen/layout.py

"""Расстановка: схема (лист A3, мм, Y вниз) и плата (мм от левого верхнего
угла платы, Y вниз, угол — градусы против часовой)."""

G = 2.54


def g(v):
    return round(v / G) * G


SCH = {}


def put(ref, x, y, rot=0):
    SCH[ref] = (g(x), g(y), rot)


# 1. Питание
put("X2", 40, 40); put("FU1", 62, 40); put("VD1", 84, 40); put("X3", 112, 40); put("X4", 136, 40)
put("C1", 35, 75); put("R1", 55, 75); put("HL1", 77, 85)
put("R2", 40, 100); put("R3", 60, 100); put("C2", 80, 100)
# 2-3. Стабилизаторы
put("C3", 32, 150); put("DA1", 68, 150); put("VD2", 102, 160, 90); put("L1", 120, 148); put("C4", 140, 150)
put("C5", 32, 205); put("DA2", 68, 205); put("VD3", 102, 215, 90); put("L2", 120, 203); put("C6", 140, 205)
put("R4", 115, 232); put("R5", 135, 232)
# 4. Драйверы
put("A1", 182, 62); put("X6", 224, 58); put("C7", 165, 110); put("X8", 200, 102)
put("A2", 254, 62); put("X7", 294, 58); put("C8", 245, 110); put("X9", 272, 102)
put("R6", 228, 110)
# 5. Серво
put("X10", 335, 40); put("X11", 365, 40); put("X12", 395, 40)
put("R7", 318, 58); put("R8", 348, 58); put("R9", 378, 58)
# 6. Ключи
put("VT1", 330, 100); put("R10", 312, 108); put("R11", 322, 122); put("VD4", 350, 92, 90); put("X13", 378, 92)
put("VT2", 330, 145); put("R12", 312, 153); put("R13", 322, 167); put("VD5", 350, 137, 90); put("X14", 378, 137)
put("VT3", 398, 118); put("R14", 395, 140); put("R15", 405, 155); put("R16", 405, 92); put("HL2", 398, 170)
# 7. Датчики
put("X17", 232, 150); put("R18", 248, 146); put("X18", 278, 150); put("R19", 292, 146)
put("X19", 172, 178); put("R20", 192, 174); put("R21", 207, 182); put("C10", 220, 182)
# 8. Разъёмы ЕТЗ
put("X20", 172, 212); put("X21", 200, 212); put("VT4", 222, 207); put("R22", 236, 222); put("R23", 247, 203)
put("X22", 285, 212); put("C11", 258, 226); put("C12", 270, 226)
# 9. (бывший разъём контроллера — свободно)
# 10. Гнёзда драйверов
put("XS1", 445, 62); put("XS2", 485, 62); put("XS3", 530, 62); put("XS4", 570, 62)
# 11. Кнопки
put("SB1", 445, 150); put("R17", 465, 145); put("C9", 478, 156)
put("SB2", 500, 150); put("R24", 520, 145); put("C13", 533, 156)
put("SB3", 555, 150); put("R25", 575, 145); put("C14", 585, 156)
# 12. Контроллер ESP32-S3 в гнёздах и дисплей
put("A3", 85, 300); put("XS5", 175, 300); put("XS6", 235, 300); put("X24", 330, 300)

BLOCKS = [
    ("Питание и останов", 22, 22, 150, 118),
    ("Стабилизатор 5 В — серво", 22, 122, 150, 178),
    ("Стабилизатор 6 В — помпа, клапан", 22, 182, 150, 245),
    ("Драйверы шаговых двигателей", 152, 22, 300, 124),
    ("Сервоприводы", 302, 22, 415, 72),
    ("Датчики", 152, 127, 300, 190),
    ("Разъёмы А, Б, В (ЕТЗ п. 3.6)", 152, 193, 300, 245),
    ("Ключи: помпа, клапан, красный индикатор", 302, 75, 415, 180),
    ("Гнёзда сменных драйверов (модули A1, A2)", 420, 22, 590, 124),
    ("Кнопки: «Старт», выбор, ввод", 420, 127, 590, 190),
    ("Контроллер ESP32-S3-DevKitC-1 (съёмный, в XS5, XS6) и дисплей 0,96\" ST7735S", 22, 252, 400, 350),
]

# ---------------------------------------------------------------- плата
BOARD_W, BOARD_H = 130.0, 95.0
PCB = {}


def pp(ref, x, y, rot=0, side="F"):
    PCB[ref] = (x, y, rot, side)

BOARD_W, BOARD_H = 125.0, 110.0
# Плата лежит за моторами на удлинённой назад фанере: верхний край (v = 0)
# смотрит на моторы (x робота -75), нижний — назад (x -185), левый край
# (u = 0) — у y -25, правый — у y -150 (за ним макетная плата).
# верх: моторы и гнёзда драйверов; A1/A2 — где стоял бы модуль (по нему
# ставятся гнёзда XS: левое — на вывод 1 модуля, правое — на вывод 16)
pp("X6", 17.3, 4); pp("A1", 30, 12, 270); pp("C7", 5, 20, 90); pp("X8", 20, 31)
pp("X7", 43.3, 4); pp("A2", 56, 12, 270); pp("C8", 36, 32); pp("X9", 46, 31)
PCB["XS1"] = ("A1", "1"); PCB["XS2"] = ("A1", "16"); PCB["XS3"] = ("A2", "1"); PCB["XS4"] = ("A2", "16")
pp("R6", 28, 34)
# верх справа: серво, помпа, клапан
pp("X10", 62, 4, 90); pp("X11", 71, 4, 90); pp("X12", 80, 4, 90)
pp("R7", 64.5, 11); pp("R8", 73.5, 11); pp("R9", 82.5, 11)
pp("X13", 91, 4); pp("X14", 100, 4)
pp("VT1", 93, 13); pp("R10", 89, 16, 90); pp("R11", 93, 18); pp("VD4", 93.5, 22.5)
pp("VT2", 102, 13); pp("R12", 98, 16, 90); pp("R13", 102, 18); pp("VD5", 103.5, 22.5)
# стабилизаторы справа
pp("C3", 63, 38); pp("DA1", 80, 38); pp("L1", 94, 38); pp("C4", 104, 38); pp("VD2", 80, 48)
pp("C5", 63, 62); pp("DA2", 80, 62); pp("L2", 94, 62); pp("C6", 104, 62); pp("VD3", 80, 72)
pp("R4", 96, 73, 90); pp("R5", 99, 73, 90)
# правый край: разъёмы ЕТЗ А, Б, В — рядом с макетной платой
pp("X20", 121, 38); pp("X21", 121, 48); pp("X22", 121, 58)
pp("VT4", 115, 48); pp("R22", 113, 53, 90); pp("R23", 117, 53, 90)
# правый низ: питание
pp("X2", 107, 90); pp("FU1", 85, 84); pp("VD1", 90, 93)
pp("X3", 80, 103, 180); pp("X4", 94, 103, 180); pp("C1", 108, 103)
# левый край: датчики Холла
pp("X17", 3.5, 46, 90); pp("X18", 3.5, 60, 90); pp("R18", 9, 46, 90); pp("R19", 9, 60, 90)
# дисплей 0,96" (модуль над платой ~11 мм, под ним — только SMD), кнопки, светодиоды
pp("X24", 14, 40, 90)
DISPLAY_AREA = (11.0, 37.0, 36.0, 69.0)
pp("SB1", 40, 40); pp("SB2", 40, 52); pp("SB3", 40, 64)
pp("HL2", 52, 42); pp("HL1", 52, 54)
pp("R16", 58, 42, 90); pp("R1", 58, 54, 90)
pp("R17", 51, 62); pp("C9", 55, 62); pp("R24", 51, 66); pp("C13", 55, 66); pp("R25", 51, 70); pp("C14", 55, 70)
# над ESP32: ключ красного индикатора, делитель останова, модуль датчика вакуума
pp("VT3", 20, 76); pp("R14", 16, 76, 90); pp("R15", 24, 76, 90)
pp("R2", 30, 76, 90); pp("R3", 33, 76, 90); pp("C2", 36, 76, 90)
pp("X19", 40, 76, 90)
pp("R20", 50, 76, 90); pp("R21", 53, 76, 90); pp("C10", 56, 76, 90)
pp("C11", 68, 79); pp("C12", 68, 76)
# контроллер ESP32-S3-DevKitC-1 в гнёздах: J1 (XS5) и J3 (XS6) — 22.86 мм
# между рядами, вывод 1 — справа, USB — к левому краю
pp("XS5", 63, 81.5, 270); pp("XS6", 63, 81.5 + 22.86, 270)
ESP_AREA = (0.5, 80.2, 64.8, 105.7)
# крепёж M3 по углам
pp("H1", 4, 4); pp("H2", 121, 4); pp("H3", 4, 106); pp("H4", 121, 106)
