sigizmund993/ETZ2067/(commit log)

2026-10-06 Initial commit: ETZ polygon model + FreeCAD MCP setup
    - ETZ_poligon.FCMacro: model generator (fixed mixed int/float
    ShapeColor tuple bug), ETZ_Poligon.FCStd: built model
    - freecad-mcp.mcpb: packaged MCP extension (addon on FreeCAD side
    auto-starts RPC on port 9875; pip freecad-mcp as the MCP server)
    - CLAUDE.md: project state, changelog, nuances for future sessions
    [ETZ_Poligon.FCStd]
2026-10-11 Параметрический привод руки: шкив GT2, седло под трубу, крышка хомута
    Модель ETZ_Robot: ведомый шкив, хомут для трубы руки и прижимная крышка.
    Все размеры вынесены в VarSet "Привод" — геометрия меняется правкой
    переменных в GUI, макрос нужен только для первой сборки.
    Связи выражениями:
    Peredacha -> число зубьев, диаметры, круговой массив
    Peredacha + DlinaRemnya-> межосевое (формула длины ремня) -> Placemen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
    [ETZ_Robot.FCStd]
2026-10-11 Окна облегчения, пазы гаек и крепёж хомута из библиотеки
    Шкив:
    - 3 окна облегчения (OknoChislo/OknoUgol), фаза 180/N - угол/2, поэтому
    спица всегда приходится под седло руки
    - пазы под гайки M3, открытые на боковую грань: гайка заводится сбоку,
    тянущее усилие держит потолок паза, подошвы под гайкой нет
    - ближняя к центру пара винтов сверлится насквозь через весь шкив,
    длина винта перестала быть кр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
    [ETZ_Robot.FCStd]
2026-10-12 Шарнир тяги на уровне рычага, крепёж всех хомутов локтя
    Шарнир тяги (Body_RodJoint + крышка) на свободном конце трубы 2:
    проушина лежит ровно в полосе рычага второго шкива, поэтому тяга между
    ними — плоская планка, а не Z-образная. Палец стоит на LeverLen от оси
    локтя (условие параллелограмма), труба кончается на JointReach раньше —
    пролёт закрывает планка проушины, входящая в торцевую стенку хомута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
    [ETZ_Robot.FCStd]
2026-10-12 Тяга параллелограмма, моторы бок о бок позади руки
    Тяга (Body_Rod) — плоская планка между отверстием рычага и пальцем
    шарнира тяги, плюс два пальца M3 с гайками. Оба конца тело находит само
    через RodAX/RodAY и RodBX/RodBY, длину и угол — через RodLen и
    atan2(RodAngle), поэтому при повороте рычага или предплечья тяга
    поворачивается и растягивается сама. Параллелограмм замкнут, когда
    RodLen == PivotX: 175.50 против 175.50.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
    [ETZ_Robot.FCStd]
2026-10-14 Станина, рабочий узел и проверка по ЕТЗ 2026-27 (11 кл., ЗЭ)
    Станина: основание в зоне 1, плиты моторов с пазами натяжения, вал M8,
    стопка внутренних колец 608ZZ зажата болтом. Рабочий узел: ось Z на
    рейке (SG90, ход 34.6), шпиндель на 2x624ZZ, поворот 0..360 через
    13->26, электромагнит. Полигон-ссылка в документе робота.
    Исправлено в приводе: проставка тёрлась о шкив 1, шарниры тяги без
    подшипников (теперь 623ZZ),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
    [ETZ_Robot.FCStd]
2026-10-15 Моторы перевёрнуты валом вниз, рука опущена на 34.5 мм
    Моторы стоят фланцем на плитах станины, ведущие шкивы под плитами.
    Вся стопка шкивов и рука опущены (BeltPlaneZ 52 -> 17.5); рельс
    захвата продлён вверх, ход и высоты магнита над полем прежние.
    Следствия, найденные проверкой и исправленные: тяга над плитой мотора 1
    (DrvGap 3, RodStandoff 3), кончики винтов хомутов локтя под хомутом
    (M3x12, гнёзда гаек под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
    [ETZ_Robot.FCStd]
2026-10-15 Ось Z на покупной направляющей MGN9 + каретке MGN9H
    Печатная T-направляющая заменена рельсом MGN9 100 мм (5x M3x8 во
    вставки) и кареткой MGN9H, к которой спереди 4x M3x8 крепится печатная
    плита каретки с рейкой и шпинделем. Фланец SG90 оси Z вынесен вперёд,
    вылет захвата 156.
    Ремень ступени 1 — GT2-320: с длинным вылетом при плече около -110°
    планка тяги проходила в 1 мм от левого мотора, теперь 11 мм.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
    [ETZ_Robot.FCStd]
2026-10-19 Основание из фанеры 6 мм, станина — небольшие печатные стойки
    Цельная печатная станина (226x225, ~517 г) заменена фанерной плитой и
    шестью стойками на вставках M3x5 и потайных M3x10 снизу. Проверка по
    ЕТЗ — все разделы OK.
    [ETZ_Robot.FCStd]
2026-10-19 Парковка целиком над зоной 1 и проверка начала/конца работы
    Прежняя поза (-100, 90) держала рабочий узел над полосой зоны 2 с
    запасом 5 мм: при ошибке 2° он выходил за полигон. Новая (136, 100):
    всё над зоной 1, допуск ±2°, магнит вверху и внизу, переезд из рабочей
    зоны без касаний. Новая проверка park().
2026-10-19 Камера USB 8 Мп на откидной консоли над полем
    Мачта Ø16x330 в заднем углу фанеры, ступица консоли на 2x 625ZZ,
    поворот SG90 через z13 -> z30. В работе камера неподвижно над центром
    листа на 327 мм, до старта и после финиша консоль сложена над зоной 1.
    Новая проверка cam(); park — со сложенной консолью. Все разделы OK.
    [ETZ_Robot.FCStd]
2026-11-01 Захват на 3 присосках DP8, камера с выносной осью, поза в Poza, перетаскивание мышью, печать на K2 Plus
    [ETZ_Robot.FCStd, derzhatel_enf.3mf, derzhatel_prisosok.stl, derzhatel_prisosok_K2Plus.3mf, enforcer_derzhatel.stl, enforcer_kronshtein_Z.stl, kronshtein_Z.stl, kronshtein_Z_K2Plus.3mf]
2026-11-01 Захват на одной присоске DP8 по оси шпинделя
    [ETZ_Robot.FCStd, derzhatel_1_enf.3mf, derzhatel_enf.3mf, derzhatel_prisoski.stl, derzhatel_prisoski_K2Plus.3mf, derzhatel_prisosok.stl, derzhatel_prisosok_K2Plus.3mf, enforcer_derzhatel.stl]
2026-11-02 Правый мотор валом вверх, плиты моторов из фанеры на латунных стойках
    - Правый мотор висит под фанерной плитой 2 (корпус z 0..40), шкив 2 над
    плитой; Motor2FaceZ считается от венца шкива 2 (Drive.Plate2T, Drv2Gap).
    - Печатные стенки FR_Post1..5 с гайками заменены покупными латунными
    стойками M3 (3x M3x30, 4x M3x40 + шайбы DIN 125), снизу потайные винты,
    сверху ISO 7380 сквозь пазы натяжения. Плиты 1 и 2 — фанера 6 мм.
    - DrvGap 3 -> 2.5: п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
    [ETZ_Robot.FCStd, derzhatel_1_K1C_enf.3mf, derzhatel_3_K1C_enf.3mf, derzhatel_prisoski_K1C.stl, derzhatel_prisoski_K1C_PETG.3mf, derzhatel_prisosok_3_K1C.stl, derzhatel_prisosok_3_K1C_PETG.3mf, enforcer_derzhatel_1_K1C.stl]
2026-11-04 Электроника в модели: плата приводов, Mega, полка на мачте, АКБ, датчики Холла
    - elektronika_etz.FCMacro: 54 детали EL_ в Part_Elec. Плата — STEP из KiCad
    (цвета граней), модули TMC2209 и XT30 — заглушками. Двухъярусная полка
    на мачте камеры выше хода руки (z 150 и 194): Mega, помпа, клапан,
    датчик вакуума внизу; плата, макетка 400, останов, Старт, выключатель,
    индикаторы вверху. АКБ 3S на фанере под рукой (z до 20).
    - Датчики Хол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
    [ETZ_Robot.FCStd]
2026-11-04 Плата v3 на ESP32-S3 за моторами, удлинённая фанера, камера на оси шкивов
    - Контроллер ESP32-S3-DevKitC-1 съёмный, в гнёздах PBS-22 XS5/XS6 на плате;
    дисплей 0,96" ST7735S, 3 кнопки, светодиоды, датчик вакуума XGZP6847A
    (X19), XT60, сменные TMC2209 в гнёздах. Плата 125 x 110, схема Э3 на A2.
    - Основание удлинено назад (Etz.BaseRearX0/Y0/Y1), плата на стойках M3x35
    за моторами, под ней АКБ, помпа, клапан; полка на мачте и Mega убраны.
    - Мачта камеры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
    [ETZ_Robot.FCStd, etz_plata.kicad_pcb, etz_plata.kicad_sch, etz_plata.step, pe3.kicad_sch, pe3_2.kicad_sch, pe3_3.kicad_sch, pe3_4.kicad_sch]
